goran-mahovlic/LVDS_RGB_experimental/README.md

# LVDS_RGB_experimental

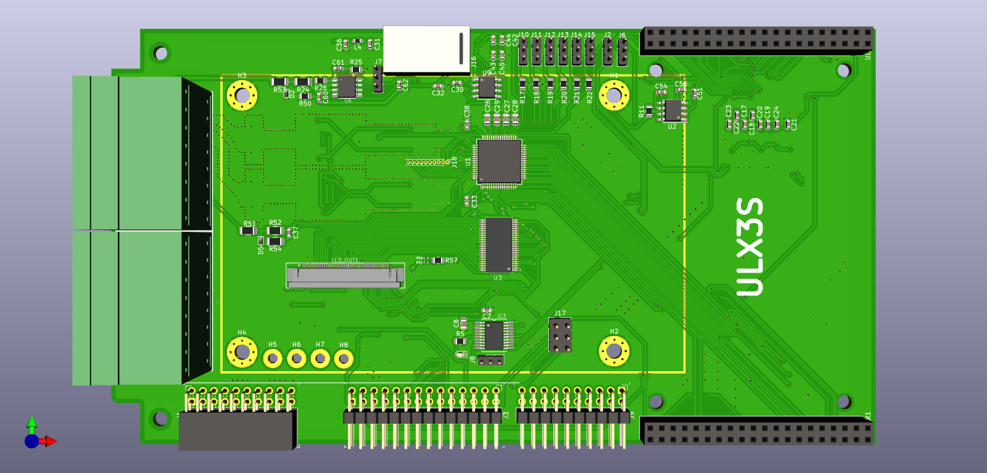
[picture p1: hardware/pic/Front.png]
Front


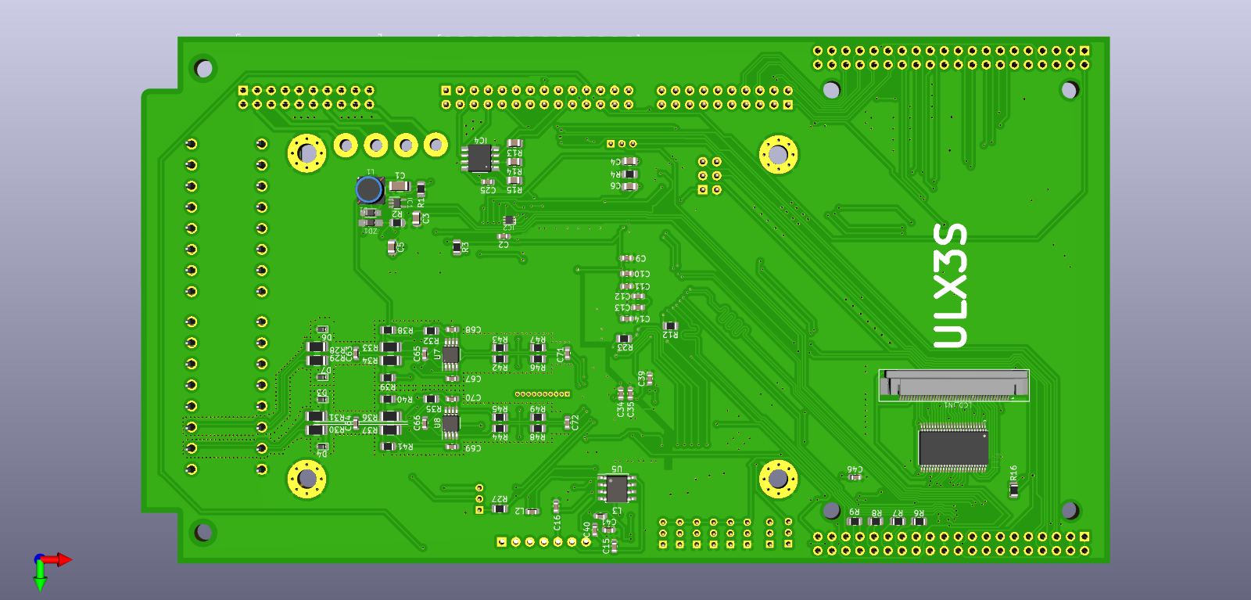
[picture p2: hardware/pic/Back.png]
Back
