goran-mahovlic/LVDS_RGB_experimental/hardware/pic/Back.jpg

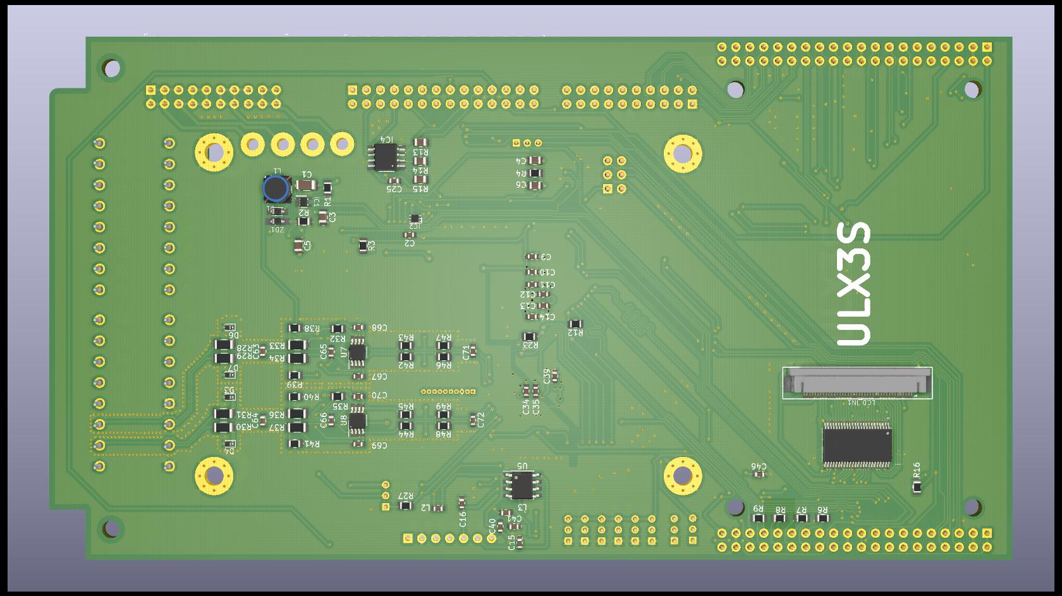
hardware/pic/Back.jpg
