goran-mahovlic/LVDS_RGB_experimental/hardware/pic/Front.jpg

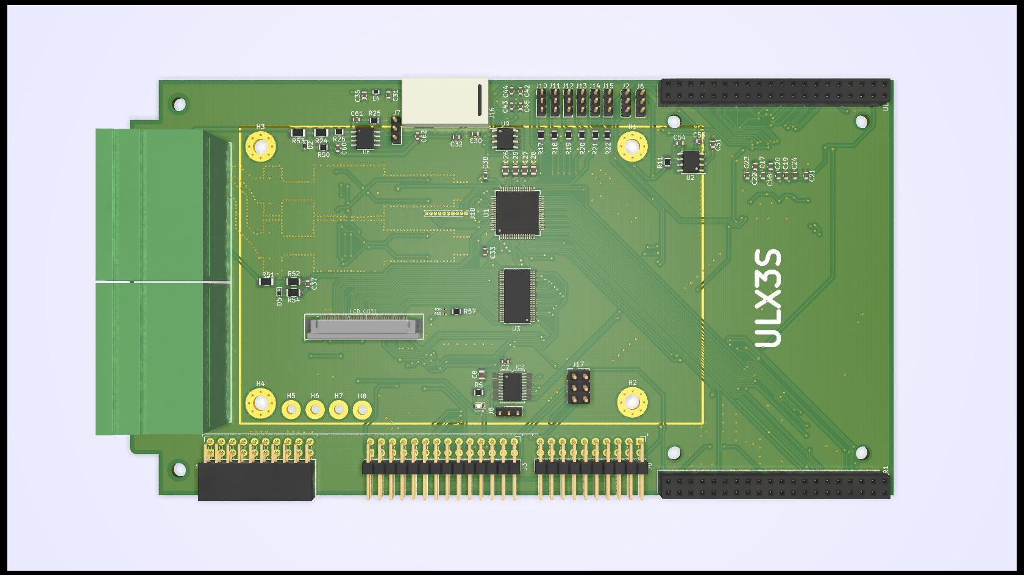
hardware/pic/Front.jpg
