goran-mahovlic/LVDS_RGB_experimental/hardware/ULX3S_Combined.FCStd

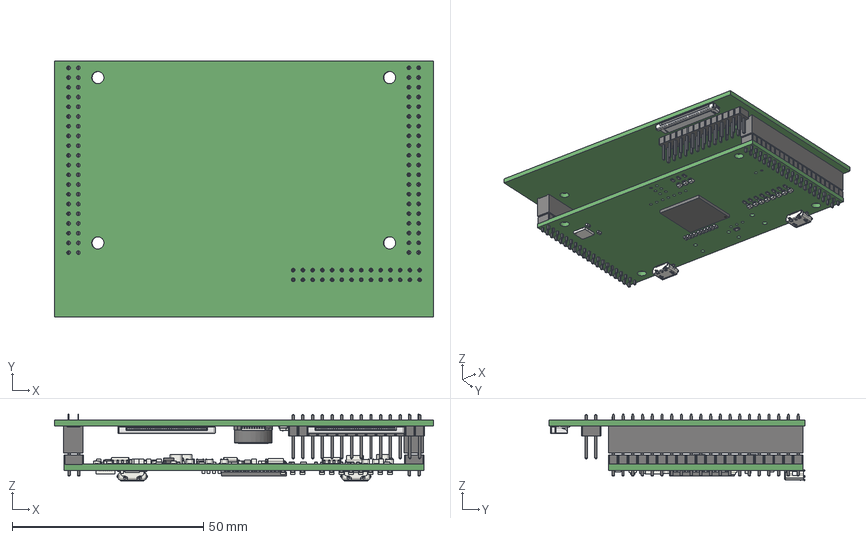
[picture p5: CAD file, 2020-01-20]
hardware/ULX3S_Combined.FCStd
99.0 x 67.0 x 17.4 mm
