goran-mahovlic/LVDS_RGB_experimental/hardware/3D/c-4-1734592-0-c-3d.stp

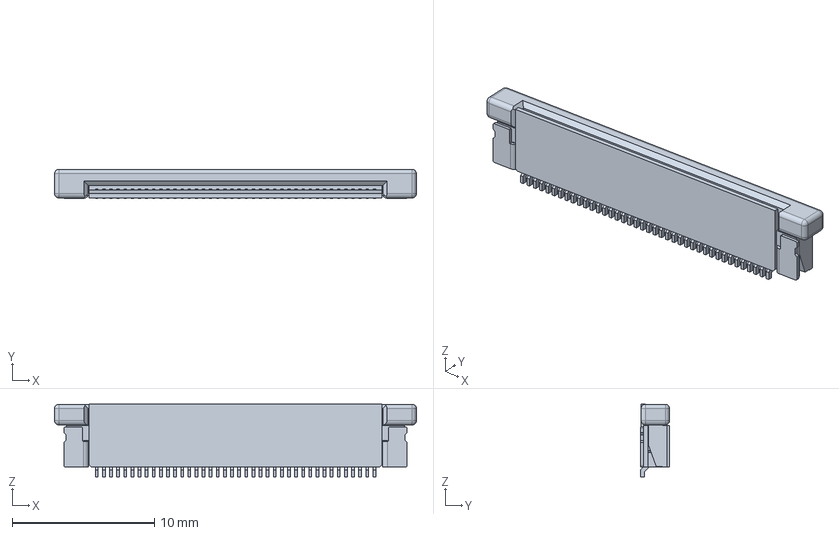
[picture p6: CAD file, 2020-01-20]
hardware/3D/c-4-1734592-0-c-3d.stp
25.4 x 2.05 x 5.11 mm
