goran-mahovlic/LVDS_RGB_experimental/hardware/3D/691327310016_Download_STP_691327310016_rev1.stp

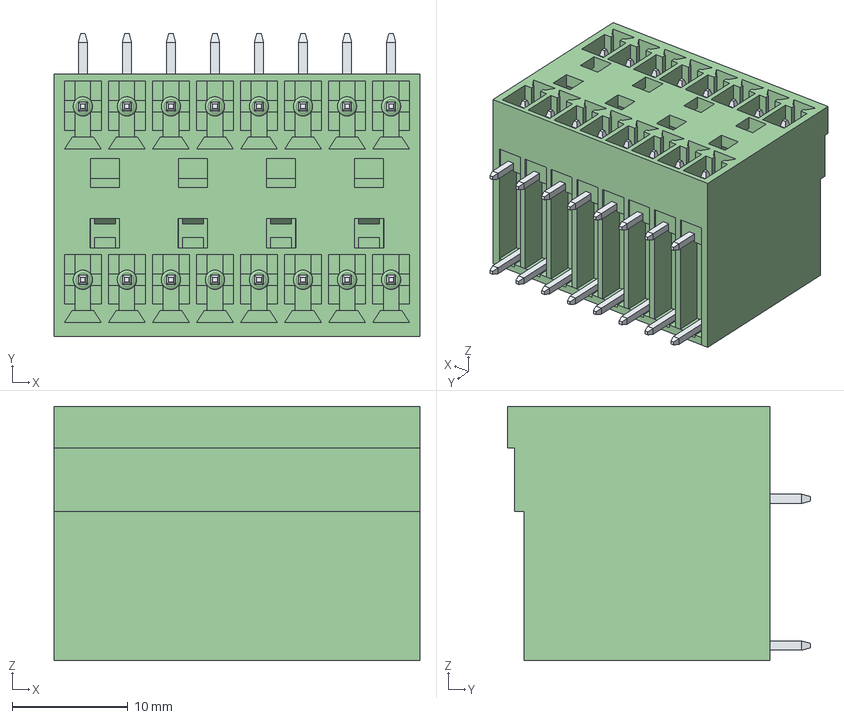
[picture p7: CAD file, 2020-01-20]
hardware/3D/691327310016_Download_STP_691327310016_rev1.stp
31.7 x 26.2 x 22.0 mm
6913273100xx_PIN x 8
6913273100xx_PIN_LONGUE x 8
691329300016_CAPOT
