goran-mahovlic/LVDS_RGB_experimental/hardware/3D/691327310012_Download_STP_691327310012_rev1.stp

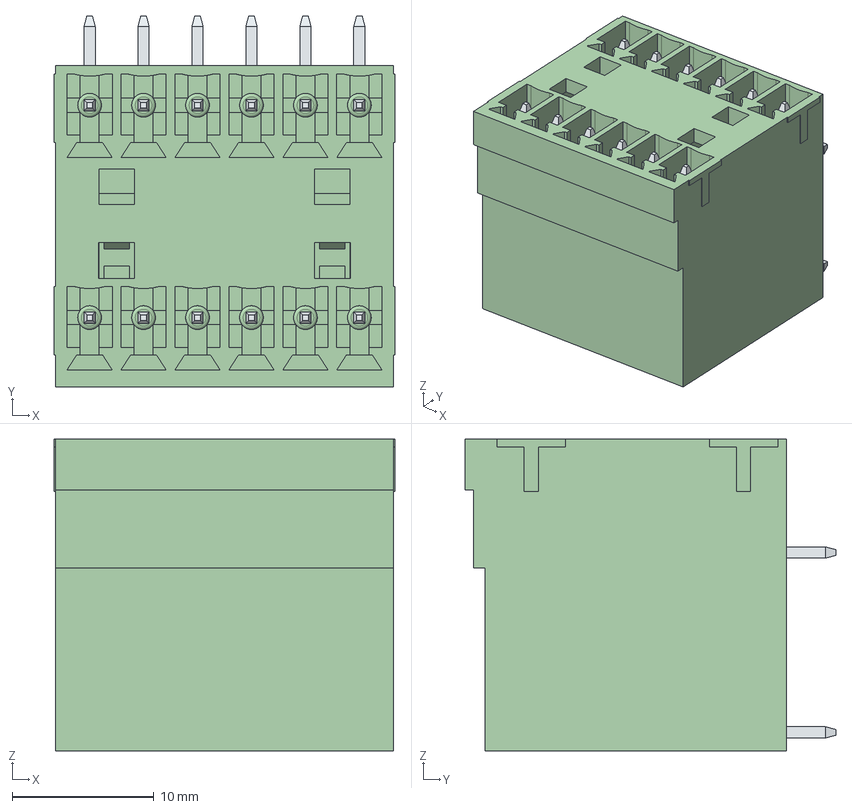
[picture p8: CAD file, 2020-01-20]
hardware/3D/691327310012_Download_STP_691327310012_rev1.stp
24.1 x 26.2 x 22.0 mm
6913273100xx_PIN x 6
6913273100xx_PIN_LONGUE x 6
691327310012_CAPOT
