goran-mahovlic/LVDS_RGB_experimental/hardware/3D/LMR14050SDDAR--3DModel-STEP-56544.STEP

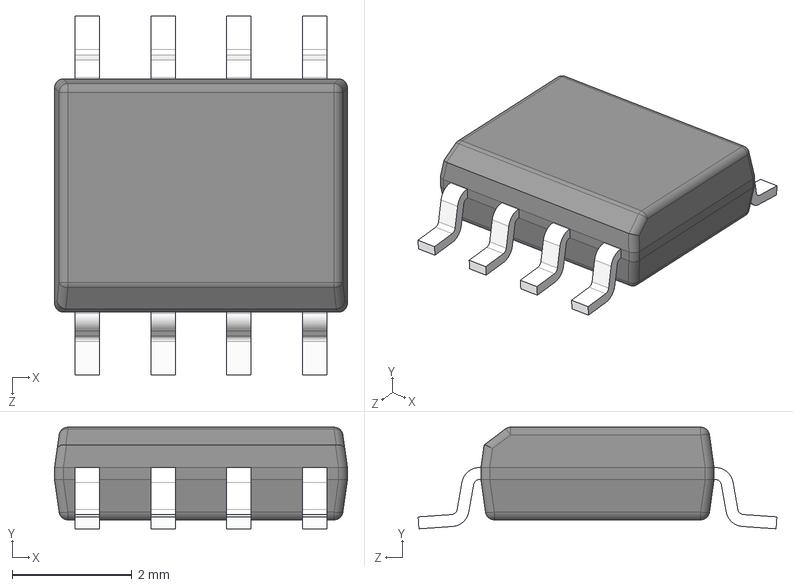
[picture p9: CAD file, 2020-01-20]
hardware/3D/LMR14050SDDAR--3DModel-STEP-56544.STEP
4.90 x 1.70 x 6.00 mm
