goran-mahovlic/LVDS_RGB_experimental/(threads)

Thread 1 (2020-02-24):

Replace all resistors and capacitors with same size

goran-mahovlic, 2020-02-24:
Go large ...

Thread 3 (2020-02-29):

LCD connector on back is flipped

goran-mahovlic, 2020-02-29:
If we use cable we need to flip connector

pin 1 is actually pin 40

QuickFix - rotate connector ...

Thread 4 (2020-03-02):

Power_Down needs to be directly connected to 3.3V

goran-mahovlic, 2020-03-02:
Connection toward STM32 LCD reset signal needs to be removed ...

Thread 5 (2020-04-18):

All selections jumper should be connected to DVDD not AVDD

goran-mahovlic, 2020-04-18:
Pins on ADC are 5V tolerant, but in datasheet it is stated to use DVDD (in our case that is 3.3V)
