goran-mahovlic/LVDS_RGB_experimental/hardware/LCD_PMOD.kicad_pcb

## KiCad design hardware/LCD_PMOD.kicad_pcb (2020-02-15)

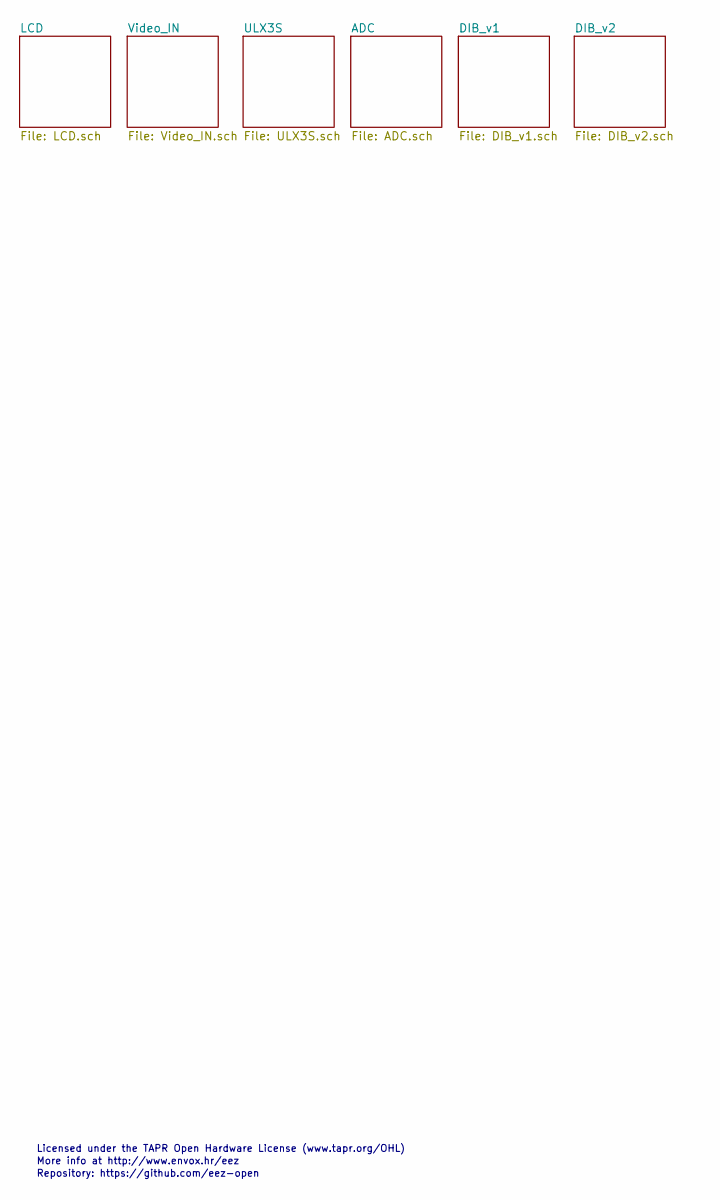
[picture p20: schematic LCD_PMOD.sch, ADC_LVDS_RGB_DIB1_DIB2]

Notes on the sheet:
Licensed under the TAPR Open Hardware License (www.tapr.org/OHL)
Repository: https://github.com/eez-open
More info at http://www.envox.hr/eez

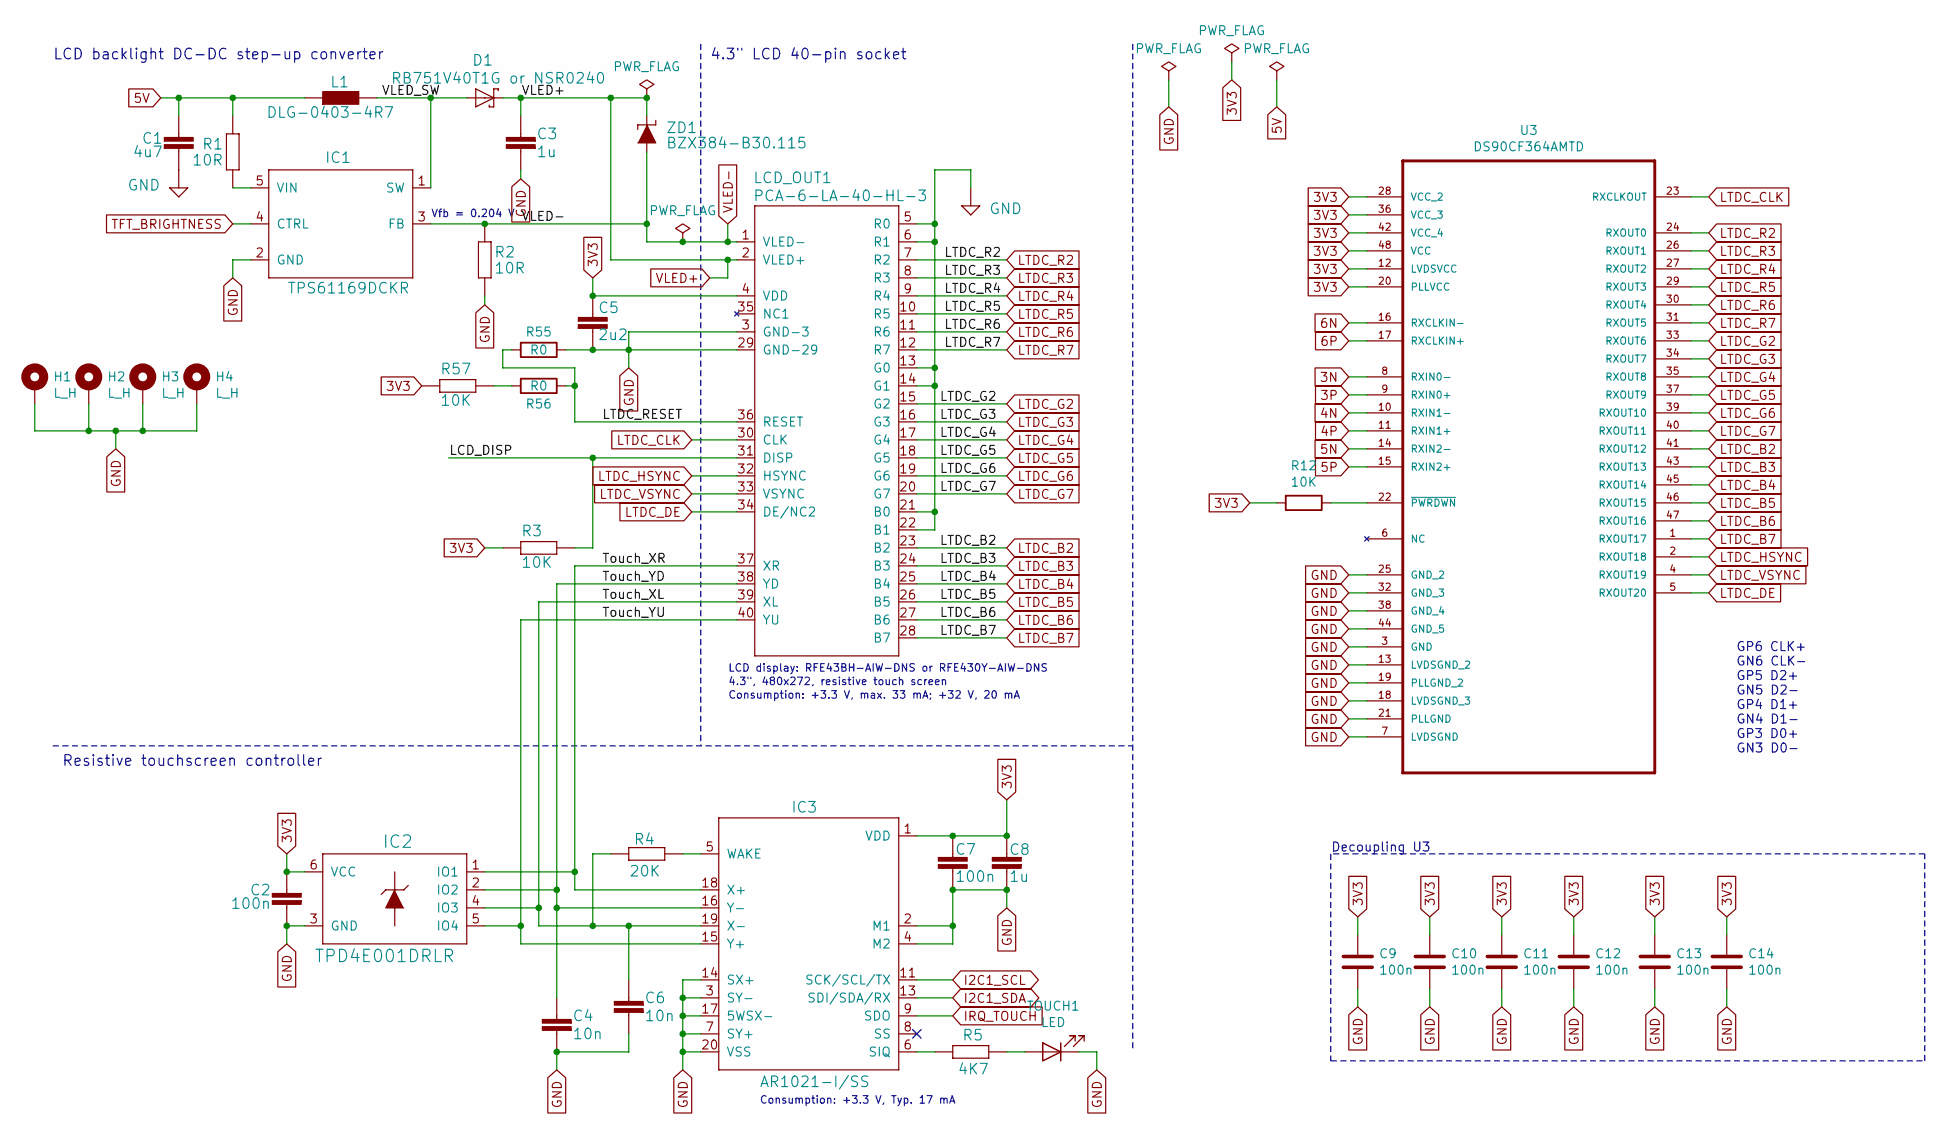
[picture p21: schematic LCD.sch]

Parts:
C1: 4u7; C_1206_3216Metric
C2, C7, C9, C10, C11, C12, C13, C14: 100n; C_0603_1608Metric
C3, C8: 1u; C_0805_2012Metric
C4, C6: 10n; C_0805_2012Metric
C5: 2u2; C_0805_2012Metric
D1: RB751V40T1G or NSR0240; SOD323-R
H1, H2, H3, H4: L_H; MountingHole_3.5mm_Pad_Via
IC1: TPS61169DCKR; DCK5
IC2: TPD4E001DRLR; DRL6
IC3: AR1021-I/SS; SOP65P780X200-20N
L1: DLG-0403-4R7; DE0403
LCD_OUT1: PCA-6-LA-40-HL-3; FPC_40
R1, R2: 10R; R_0805_2012Metric
R3, R12, R57: 10K; R_0805_2012Metric
R4: 20K; R_0805_2012Metric
R5: 4K7; R_0805_2012Metric
R55, R56: R0; R_0201_0603Metric
TOUCH1: LED; LED_0603_1608Metric
U3: DS90CF364AMTD; SOP50P800X110-48N
ZD1: BZX384-B30.115; SOD323-W

Connections:
3N: U3.8 (RXIN0-); also elsewhere on the board
3P: U3.9 (RXIN0+); also elsewhere on the board
3V3: C2.2, C5.1, C7.2, C8.2, C9.1, C10.1, C11.1, C12.1, C13.1, C14.1, IC2.6 (VCC), IC3.1 (VDD), LCD_OUT1.4 (VDD), R3.2, R12.2, R57.2, U3.12 (LVDSVCC), U3.20 (PLLVCC), U3.28 (VCC_2), U3.36 (VCC_3), U3.42 (VCC_4), U3.48 (VCC); also elsewhere on the board
4N: U3.10 (RXIN1-); also elsewhere on the board
4P: U3.11 (RXIN1+); also elsewhere on the board
5N: U3.14 (RXIN2-); also elsewhere on the board
5P: U3.15 (RXIN2+); also elsewhere on the board
5V: C1.1, L1.1, R1.1; also elsewhere on the board
6N: U3.16 (RXCLKIN-); also elsewhere on the board
6P: U3.17 (RXCLKIN+); also elsewhere on the board
8N: IC1.4 (CTRL); also elsewhere on the board
/LCD/LCD_DISP: LCD_OUT1.31 (DISP), R3.1
/LCD/LTDC_RESET: LCD_OUT1.36 (RESET), R55.2, R56.1
/LCD/Touch_XL: C6.1, IC2.4 (IO3), IC3.19 (X-), LCD_OUT1.39 (XL), R4.2
/LCD/Touch_XR: IC2.1 (IO1), IC3.18 (X+), LCD_OUT1.37 (XR)
/LCD/Touch_YD: C4.1, IC2.2 (IO2), IC3.16 (Y-), LCD_OUT1.38 (YD)
/LCD/Touch_YU: IC2.5 (IO4), IC3.15 (Y+), LCD_OUT1.40 (YU)
/LCD/VLED_SW: D1.A, IC1.1 (SW), L1.2
GND: C1.2, C2.1, C3.2, C4.2, C5.2, C6.2, C7.1, C8.1, C9.2, C10.2, C11.2, C12.2, C13.2, C14.2, H1.1, H2.1, H3.1, H4.1, IC1.2 (GND), IC2.3 (GND), IC3.2 (M1), IC3.3 (SY-), IC3.4 (M2), IC3.7 (SY+), IC3.14 (SX+), IC3.17 (5WSX-), IC3.20 (VSS), LCD_OUT1.3 (GND-3), LCD_OUT1.5 (R0), LCD_OUT1.6 (R1), LCD_OUT1.13 (G0), LCD_OUT1.14 (G1), LCD_OUT1.21 (B0), LCD_OUT1.22 (B1), LCD_OUT1.29 (GND-29), R2.2, R55.1, TOUCH1.1 (K), U3.3 (GND), U3.7 (LVDSGND), U3.13 (LVDSGND_2), U3.18 (LVDSGND_3), U3.19 (PLLGND_2), U3.21 (PLLGND), U3.25 (GND_2), U3.32 (GND_3), U3.38 (GND_4), U3.44 (GND_5); also elsewhere on the board
I2C1_SCL: IC3.11 (SCK/SCL/TX); also elsewhere on the board
I2C1_SDA: IC3.13 (SDI/SDA/RX); also elsewhere on the board
IRQ_TOUCH: IC3.9 (SDO); also elsewhere on the board
LTDC_B2: LCD_OUT1.23 (B2), U3.41 (RXOUT12)
LTDC_B3: LCD_OUT1.24 (B3), U3.43 (RXOUT13)
LTDC_B4: LCD_OUT1.25 (B4), U3.45 (RXOUT14)
LTDC_B5: LCD_OUT1.26 (B5), U3.46 (RXOUT15)
LTDC_B6: LCD_OUT1.27 (B6), U3.47 (RXOUT16)
LTDC_B7: LCD_OUT1.28 (B7), U3.1 (RXOUT17)
LTDC_CLK: LCD_OUT1.30 (CLK), U3.23 (RXCLKOUT)
LTDC_DE: LCD_OUT1.34 (DE/NC2), U3.5 (RXOUT20)
LTDC_G2: LCD_OUT1.15 (G2), U3.33 (RXOUT6)
LTDC_G3: LCD_OUT1.16 (G3), U3.34 (RXOUT7)
LTDC_G4: LCD_OUT1.17 (G4), U3.35 (RXOUT8)
LTDC_G5: LCD_OUT1.18 (G5), U3.37 (RXOUT9)
LTDC_G6: LCD_OUT1.19 (G6), U3.39 (RXOUT10)
LTDC_G7: LCD_OUT1.20 (G7), U3.40 (RXOUT11)
LTDC_HSYNC: LCD_OUT1.32 (HSYNC), U3.2 (RXOUT18)
LTDC_R2: LCD_OUT1.7 (R2), U3.24 (RXOUT0)
LTDC_R3: LCD_OUT1.8 (R3), U3.26 (RXOUT1)
LTDC_R4: LCD_OUT1.9 (R4), U3.27 (RXOUT2)
LTDC_R5: LCD_OUT1.10 (R5), U3.29 (RXOUT3)
LTDC_R6: LCD_OUT1.11 (R6), U3.30 (RXOUT4)
LTDC_R7: LCD_OUT1.12 (R7), U3.31 (RXOUT5)
LTDC_VSYNC: LCD_OUT1.33 (VSYNC), U3.4 (RXOUT19)
unnamed: IC1.5 (VIN), R1.2
unnamed: IC3.5 (WAKE), R4.1
unnamed: IC3.6 (SIQ), R5.2
unnamed: R5.1, TOUCH1.2 (A)
unnamed: R12.1, U3.22 (~PWRDWN)
unnamed: R56.2, R57.1
VLED+: C3.1, D1.C, LCD_OUT1.2 (VLED+), ZD1.C; also elsewhere on the board
VLED-: IC1.3 (FB), LCD_OUT1.1 (VLED-), R2.1, ZD1.A; also elsewhere on the board

Notes on the sheet:
4.3" LCD 40-pin socket
LCD backlight DC-DC step-up converter
Consumption: +3.3 V, Typ. 17 mA
Consumption: +3.3 V, max. 33 mA; +32 V, 20 mA
Vfb = 0.204 V
LCD display: RFE43BH-AIW-DNS or RFE430Y-AIW-DNS
4.3", 480x272, resistive touch screen
Resistive touchscreen controller
GP6 CLK+ GN6 CLK- GP5 D2+ GN5 D2- GP4 D1+ GN4 D1- GP3 D0+ GN3 D0-
Decoupling U3

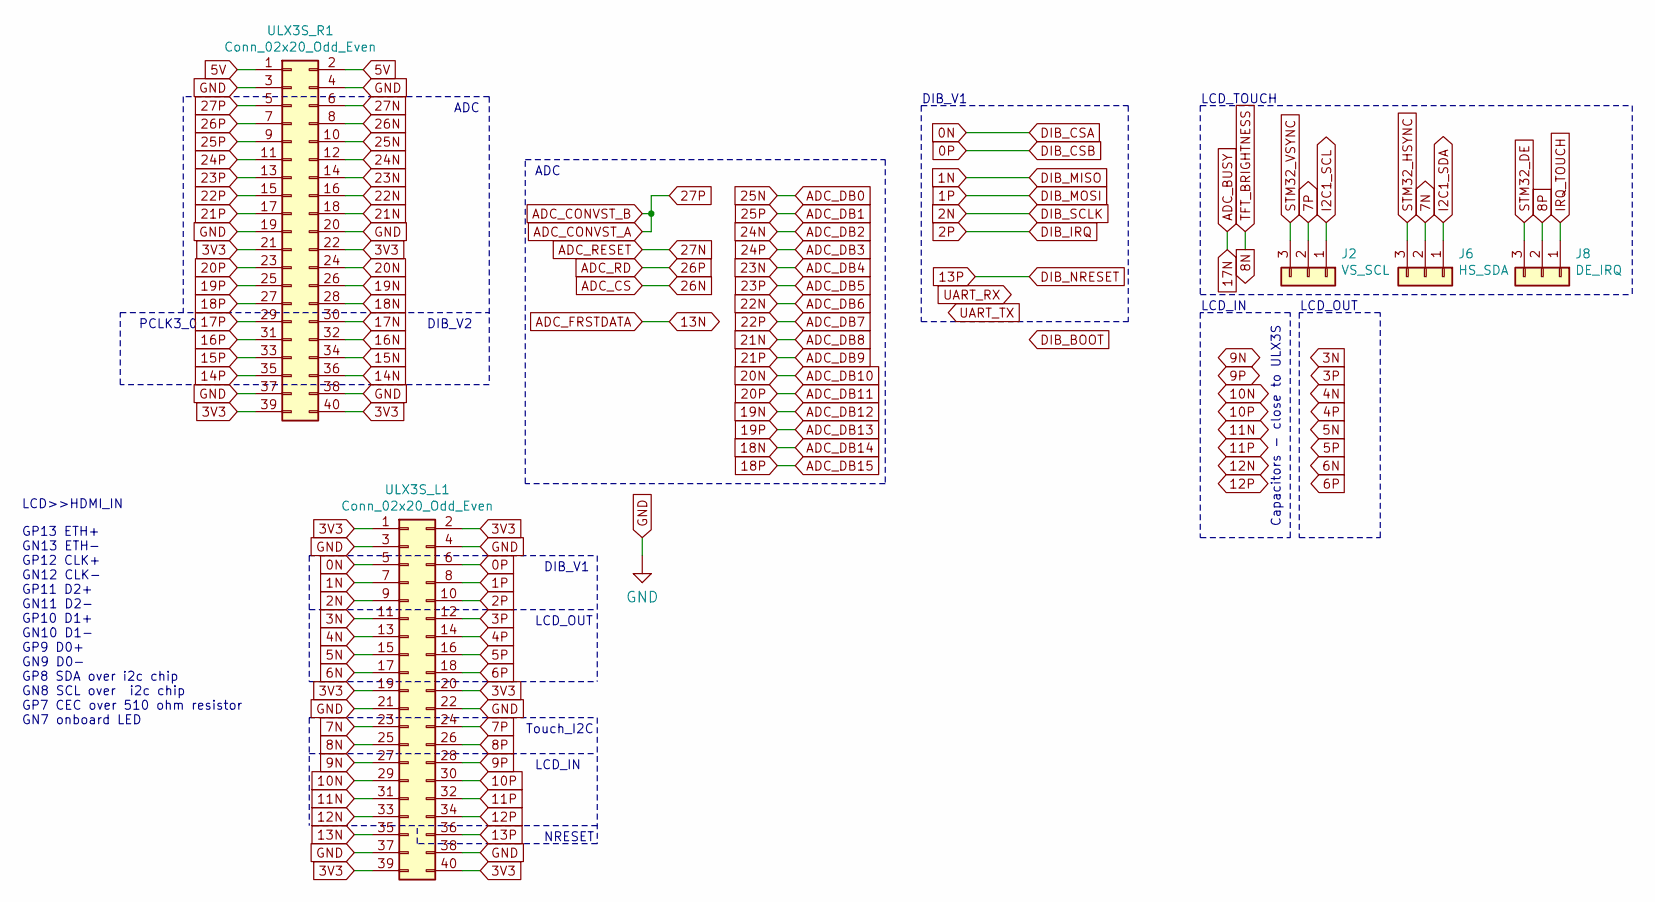
[picture p22: schematic ULX3S.sch]

Parts:
J2: VS_SCL; PinHeader_1x03_P2.00mm_Vertical
J6: HS_SDA; PinHeader_1x03_P2.00mm_Vertical
J8: DE_IRQ; PinHeader_1x03_P2.00mm_Vertical
ULX3S_L1, ULX3S_R1: Conn_02x20_Odd_Even; PinSocket_2x20_P2.54mm_Vertical

Connections:
0N: ULX3S_L1.5; also elsewhere on the board
0P: ULX3S_L1.6; also elsewhere on the board
1N: ULX3S_L1.7; also elsewhere on the board
1P: ULX3S_L1.8; also elsewhere on the board
2N: ULX3S_L1.9; also elsewhere on the board
2P: ULX3S_L1.10; also elsewhere on the board
3N: ULX3S_L1.11; also elsewhere on the board
3P: ULX3S_L1.12; also elsewhere on the board
3V3: ULX3S_L1.1, ULX3S_L1.2, ULX3S_L1.19, ULX3S_L1.20, ULX3S_L1.39, ULX3S_L1.40, ULX3S_R1.21, ULX3S_R1.22, ULX3S_R1.39, ULX3S_R1.40; also elsewhere on the board
4N: ULX3S_L1.13; also elsewhere on the board
4P: ULX3S_L1.14; also elsewhere on the board
5N: ULX3S_L1.15; also elsewhere on the board
5P: ULX3S_L1.16; also elsewhere on the board
5V: ULX3S_R1.1, ULX3S_R1.2; also elsewhere on the board
6N: ULX3S_L1.17; also elsewhere on the board
6P: ULX3S_L1.18; also elsewhere on the board
7N: J6.2, ULX3S_L1.23
7P: J2.2, ULX3S_L1.24
8N: ULX3S_L1.25; also elsewhere on the board
8P: J8.2, ULX3S_L1.26
9N: ULX3S_L1.27; also elsewhere on the board
9P: ULX3S_L1.28; also elsewhere on the board
10N: ULX3S_L1.29; also elsewhere on the board
10P: ULX3S_L1.30; also elsewhere on the board
11N: ULX3S_L1.31; also elsewhere on the board
11P: ULX3S_L1.32; also elsewhere on the board
12N: ULX3S_L1.33; also elsewhere on the board
12P: ULX3S_L1.34; also elsewhere on the board
13N: ULX3S_L1.35; also elsewhere on the board
13P: ULX3S_L1.36; also elsewhere on the board
14N: ULX3S_R1.36; also elsewhere on the board
14P: ULX3S_R1.35; also elsewhere on the board
15N: ULX3S_R1.34; also elsewhere on the board
15P: ULX3S_R1.33; also elsewhere on the board
16N: ULX3S_R1.32; also elsewhere on the board
16P: ULX3S_R1.31; also elsewhere on the board
17N: ULX3S_R1.30; also elsewhere on the board
17P: ULX3S_R1.29; also elsewhere on the board
18N: ULX3S_R1.28; also elsewhere on the board
18P: ULX3S_R1.27; also elsewhere on the board
19N: ULX3S_R1.26; also elsewhere on the board
19P: ULX3S_R1.25; also elsewhere on the board
20N: ULX3S_R1.24; also elsewhere on the board
20P: ULX3S_R1.23; also elsewhere on the board
21N: ULX3S_R1.18; also elsewhere on the board
21P: ULX3S_R1.17; also elsewhere on the board
22N: ULX3S_R1.16; also elsewhere on the board
22P: ULX3S_R1.15; also elsewhere on the board
23N: ULX3S_R1.14; also elsewhere on the board
23P: ULX3S_R1.13; also elsewhere on the board
24N: ULX3S_R1.12; also elsewhere on the board
24P: ULX3S_R1.11; also elsewhere on the board
25N: ULX3S_R1.10; also elsewhere on the board
25P: ULX3S_R1.9; also elsewhere on the board
26N: ULX3S_R1.8; also elsewhere on the board
26P: ULX3S_R1.7; also elsewhere on the board
27N: ULX3S_R1.6; also elsewhere on the board
27P: ULX3S_R1.5; also elsewhere on the board
GND: ULX3S_L1.3, ULX3S_L1.4, ULX3S_L1.21, ULX3S_L1.22, ULX3S_L1.37, ULX3S_L1.38, ULX3S_R1.3, ULX3S_R1.4, ULX3S_R1.19, ULX3S_R1.20, ULX3S_R1.37, ULX3S_R1.38; also elsewhere on the board
I2C1_SCL: J2.1; also elsewhere on the board
I2C1_SDA: J6.1; also elsewhere on the board
IRQ_TOUCH: J8.1; also elsewhere on the board
STM32_DE: J8.3; also elsewhere on the board
STM32_HSYNC: J6.3; also elsewhere on the board
STM32_VSYNC: J2.3; also elsewhere on the board

Notes on the sheet:
GP13 ETH+ GN13 ETH- GP12 CLK+ GN12 CLK- GP11 D2+ GN11 D2- GP10 D1+ GN10 D1- GP9 D0+ GN9 D0- GP8 SDA over i2c chip GN8 SCL over i2c chip GP7 CEC over 510 ohm resistor GN7 onboard LED
LCD>>HDMI_IN
DIB_V1
LCD_TOUCH
Capacitors - close to ULX3S
LCD_IN
LCD_OUT
Touch_I2C
ADC
NRESET
PCLK3_0
DIB_V2

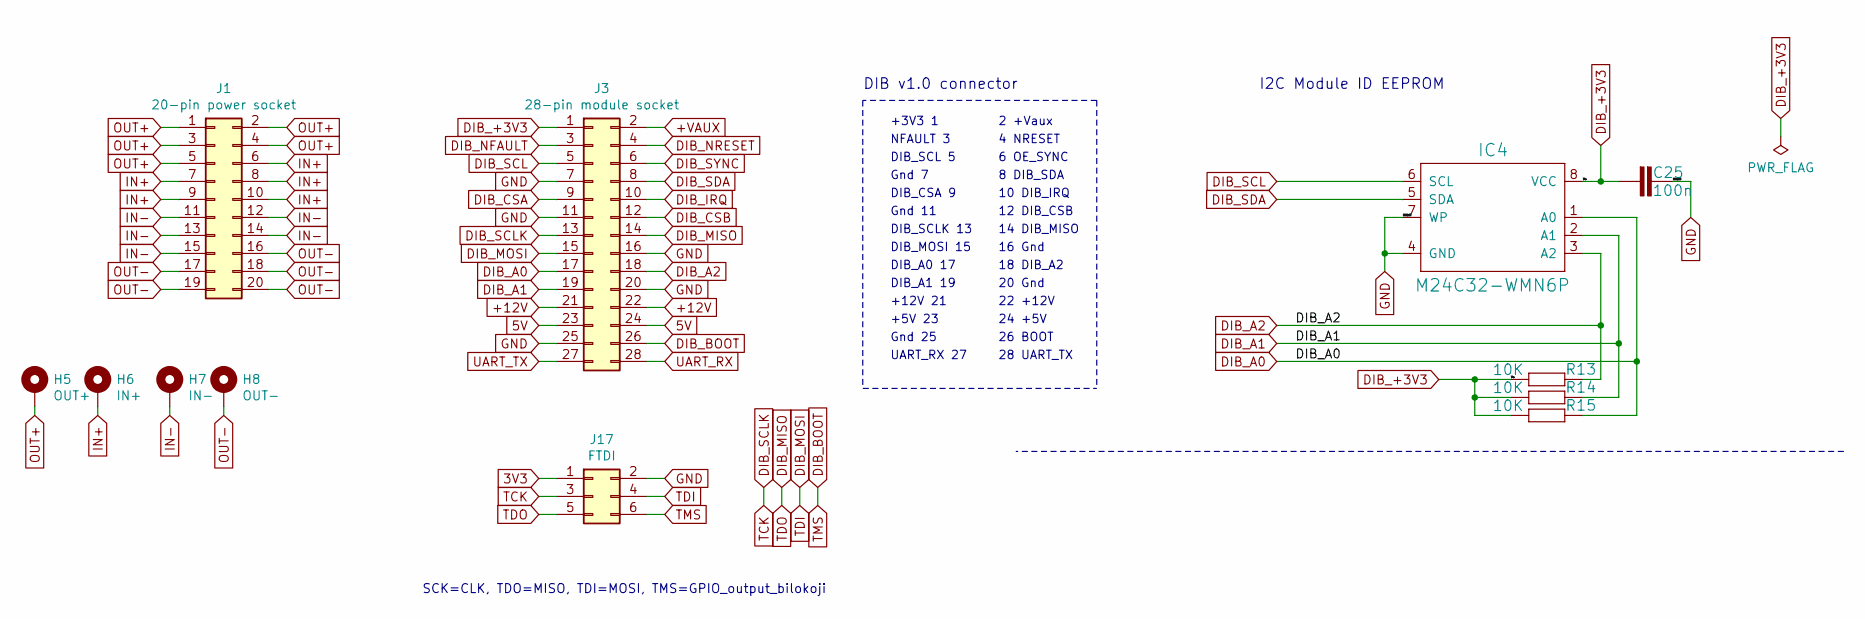
[picture p23: schematic DIB_v1.sch]

Parts:
C25: 100n; C_0603_1608Metric
H5: OUT+; MountingHole_2.2mm_M2_Pad
H6: IN+; MountingHole_2.2mm_M2_Pad
H7: IN-; MountingHole_2.2mm_M2_Pad
H8: OUT-; MountingHole_2.2mm_M2_Pad
IC4: M24C32-WMN6P; SOIC127P600X170-9N
J1: 20-pin power socket; PinSocket_2x10_P2.54mm_Horizontal_DIB_V1
J3: 28-pin module socket; PinHeader_2x14_P2.54mm_Horizontal_DIB_V1
J17: FTDI; PinHeader_2x03_P2.54mm_Vertical
R13, R14, R15: 10K; C_0805_2012Metric

Connections:
0N: J3.9; also elsewhere on the board
0P: J3.12; also elsewhere on the board
1N: J3.14, J17.5; also elsewhere on the board
1P: J3.15, J17.4; also elsewhere on the board
2N: J3.13, J17.3; also elsewhere on the board
2P: J3.10; also elsewhere on the board
3V3: J17.1; also elsewhere on the board
5V: J3.23, J3.24; also elsewhere on the board
13P: J3.4; also elsewhere on the board
+12V: J3.21, J3.22; also elsewhere on the board
DIB_+3V3: C25.2, IC4.8 (VCC), J3.1, R13.1, R14.1, R15.1
DIB_A0: IC4.1 (A0), J3.17, R15.2
DIB_A1: IC4.2 (A1), J3.19, R14.2
DIB_A2: IC4.3 (A2), J3.18, R13.2
DIB_BOOT: J3.26, J17.6
DIB_SCL: IC4.6 (SCL), J3.5
DIB_SDA: IC4.5 (SDA), J3.8
GND: C25.1, IC4.4 (GND), IC4.7 (WP), J3.7, J3.11, J3.16, J3.20, J3.25, J17.2; also elsewhere on the board
IN+: H6.1, J1.6, J1.7, J1.8, J1.9, J1.10
IN-: H7.1, J1.11, J1.12, J1.13, J1.14, J1.15
OUT+: H5.1, J1.1, J1.2, J1.3, J1.4, J1.5
OUT-: H8.1, J1.16, J1.17, J1.18, J1.19, J1.20

Notes on the sheet:
26 BOOT
Gnd 7
22 +12V
16 Gnd
6 OE_SYNC
24 +5V
+5V 23
Gnd 25
+12V 21
10 DIB_IRQ
DIB_CSA 9
2 +Vaux
12 DIB_CSB
+3V3 1
Gnd 11
8 DIB_SDA
DIB_SCL 5
DIB_A1 19
4 NRESET
DIB_A0 17
20 Gnd
NFAULT 3
14 DIB_MISO
DIB_MOSI 15
DIB_SCLK 13
18 DIB_A2
UART_RX 27
28 UART_TX
DIB v1.0 connector
I2C Module ID EEPROM
SCK=CLK, TDO=MISO, TDI=MOSI, TMS=GPIO_output_bilokoji

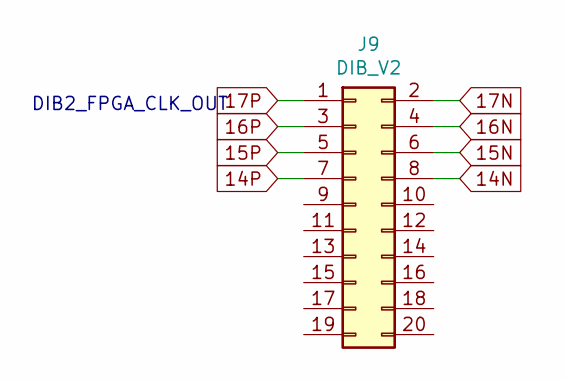
[picture p24: schematic DIB_v2.sch]

Parts:
J9: DIB_V2; PinHeader_2x10_P2.54mm_Horizontal

Connections:
14N: J9.8; also elsewhere on the board
14P: J9.7; also elsewhere on the board
15N: J9.6; also elsewhere on the board
15P: J9.5; also elsewhere on the board
16N: J9.4; also elsewhere on the board
16P: J9.3; also elsewhere on the board
17N: J9.2; also elsewhere on the board
17P: J9.1; also elsewhere on the board

Notes on the sheet:
DIB2_FPGA_CLK_OUT

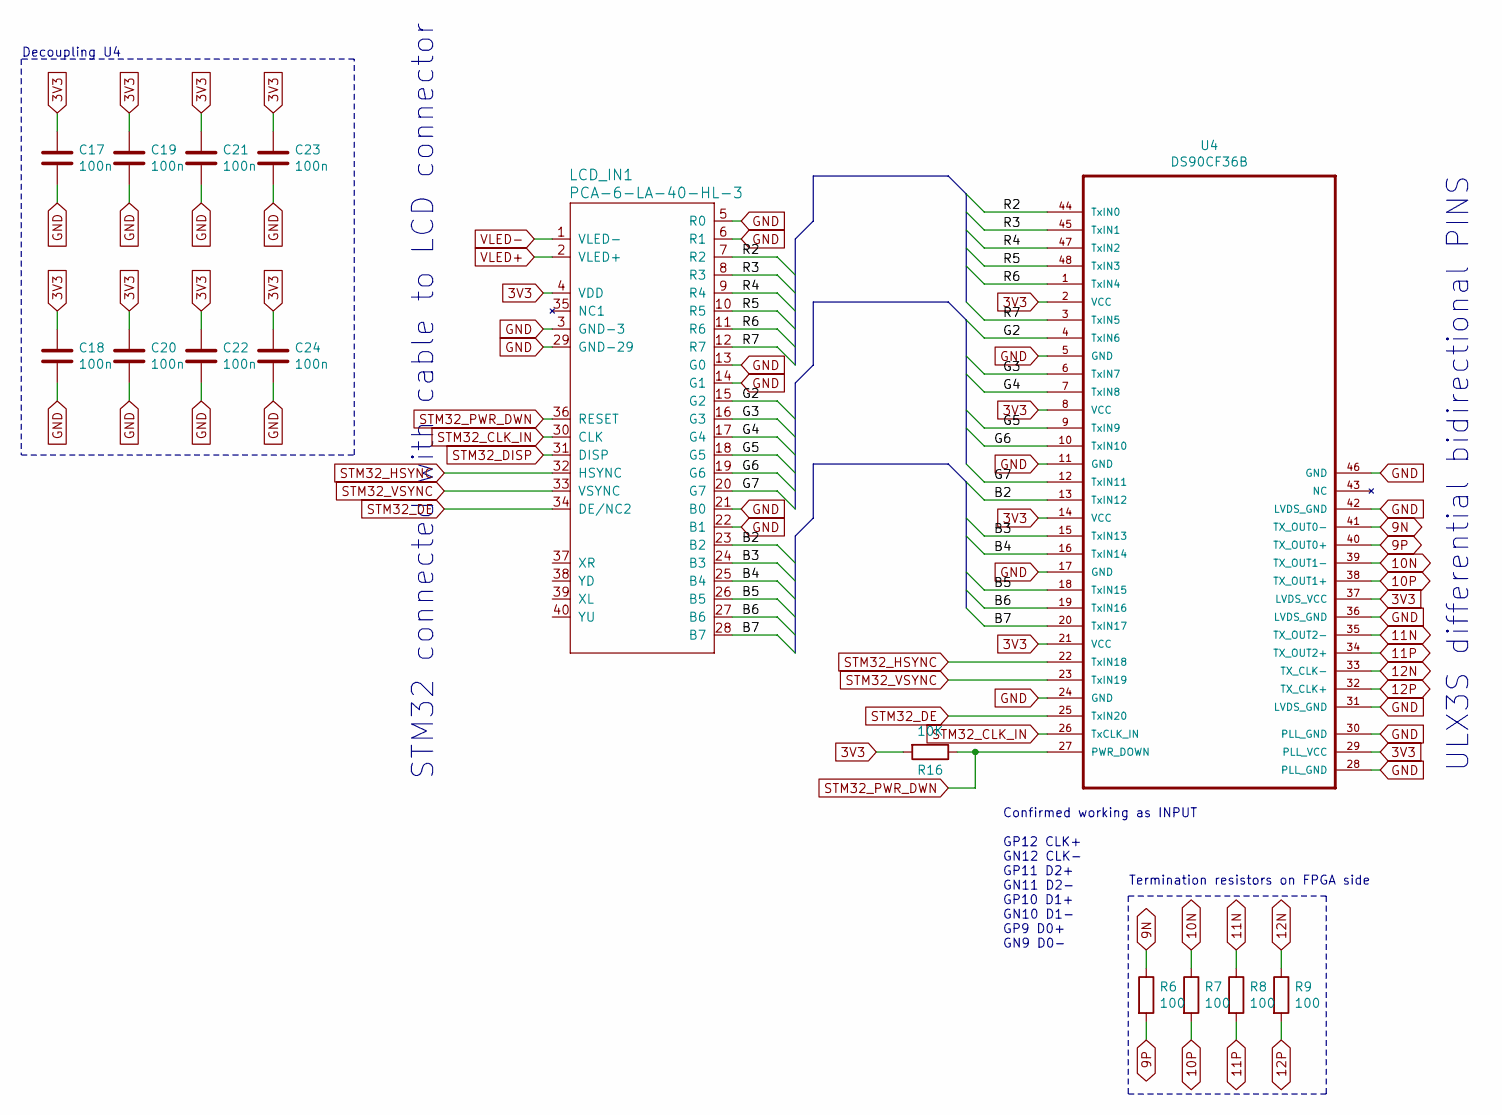
[picture p25: schematic Video_IN.sch]

Parts:
C17, C18, C19, C20, C21, C22, C23, C24: 100n; C_0603_1608Metric
LCD_IN1: PCA-6-LA-40-HL-3; FPC_40
R6, R7, R8, R9: 100; R_0805_2012Metric
R16: 10K; R_0805_2012Metric
U4: DS90CF36B; SOP50P800X110-48N

Connections:
3V3: C17.1, C18.1, C19.1, C20.1, C21.1, C22.1, C23.1, C24.1, LCD_IN1.4 (VDD), R16.2, U4.2 (VCC), U4.8 (VCC), U4.14 (VCC), U4.21 (VCC), U4.29 (PLL_VCC), U4.37 (LVDS_VCC); also elsewhere on the board
9N: R6.1, U4.41 (TX_OUT0-); also elsewhere on the board
9P: R6.2, U4.40 (TX_OUT0+); also elsewhere on the board
10N: R7.1, U4.39 (TX_OUT1-); also elsewhere on the board
10P: R7.2, U4.38 (TX_OUT1+); also elsewhere on the board
11N: R8.1, U4.35 (TX_OUT2-); also elsewhere on the board
11P: R8.2, U4.34 (TX_OUT2+); also elsewhere on the board
12N: R9.1, U4.33 (TX_CLK-); also elsewhere on the board
12P: R9.2, U4.32 (TX_CLK+); also elsewhere on the board
/Video_IN/B2: LCD_IN1.23 (B2), U4.13 (TxIN12)
/Video_IN/B3: LCD_IN1.24 (B3), U4.15 (TxIN13)
/Video_IN/B4: LCD_IN1.25 (B4), U4.16 (TxIN14)
/Video_IN/B5: LCD_IN1.26 (B5), U4.18 (TxIN15)
/Video_IN/B6: LCD_IN1.27 (B6), U4.19 (TxIN16)
/Video_IN/B7: LCD_IN1.28 (B7), U4.20 (TxIN17)
/Video_IN/G2: LCD_IN1.15 (G2), U4.4 (TxIN6)
/Video_IN/G3: LCD_IN1.16 (G3), U4.6 (TxIN7)
/Video_IN/G4: LCD_IN1.17 (G4), U4.7 (TxIN8)
/Video_IN/G5: LCD_IN1.18 (G5), U4.9 (TxIN9)
/Video_IN/G6: LCD_IN1.19 (G6), U4.10 (TxIN10)
/Video_IN/G7: LCD_IN1.20 (G7), U4.12 (TxIN11)
/Video_IN/R2: LCD_IN1.7 (R2), U4.44 (TxIN0)
/Video_IN/R3: LCD_IN1.8 (R3), U4.45 (TxIN1)
/Video_IN/R4: LCD_IN1.9 (R4), U4.47 (TxIN2)
/Video_IN/R5: LCD_IN1.10 (R5), U4.48 (TxIN3)
/Video_IN/R6: LCD_IN1.11 (R6), U4.1 (TxIN4)
/Video_IN/R7: LCD_IN1.12 (R7), U4.3 (TxIN5)
GND: C17.2, C18.2, C19.2, C20.2, C21.2, C22.2, C23.2, C24.2, LCD_IN1.3 (GND-3), LCD_IN1.5 (R0), LCD_IN1.6 (R1), LCD_IN1.13 (G0), LCD_IN1.14 (G1), LCD_IN1.21 (B0), LCD_IN1.22 (B1), LCD_IN1.29 (GND-29), U4.5 (GND), U4.11 (GND), U4.17 (GND), U4.24 (GND), U4.28 (PLL_GND), U4.30 (PLL_GND), U4.31 (LVDS_GND), U4.36 (LVDS_GND), U4.42 (LVDS_GND), U4.46 (GND); also elsewhere on the board
STM32_CLK_IN: LCD_IN1.30 (CLK), U4.26 (TxCLK_IN)
STM32_DE: LCD_IN1.34 (DE/NC2), U4.25 (TxIN20); also elsewhere on the board
STM32_HSYNC: LCD_IN1.32 (HSYNC), U4.22 (TxIN18); also elsewhere on the board
STM32_PWR_DWN: LCD_IN1.36 (RESET), R16.1, U4.27 (PWR_DOWN)
STM32_VSYNC: LCD_IN1.33 (VSYNC), U4.23 (TxIN19); also elsewhere on the board
VLED+: LCD_IN1.2 (VLED+); also elsewhere on the board
VLED-: LCD_IN1.1 (VLED-); also elsewhere on the board

Notes on the sheet:
Confirmed working as INPUT GP12 CLK+ GN12 CLK- GP11 D2+ GN11 D2- GP10 D1+ GN10 D1- GP9 D0+ GN9 D0-
STM32 connected with cable to LCD connector
ULX3S differential bidirectional PINS
Decoupling U4
Termination resistors on FPGA side

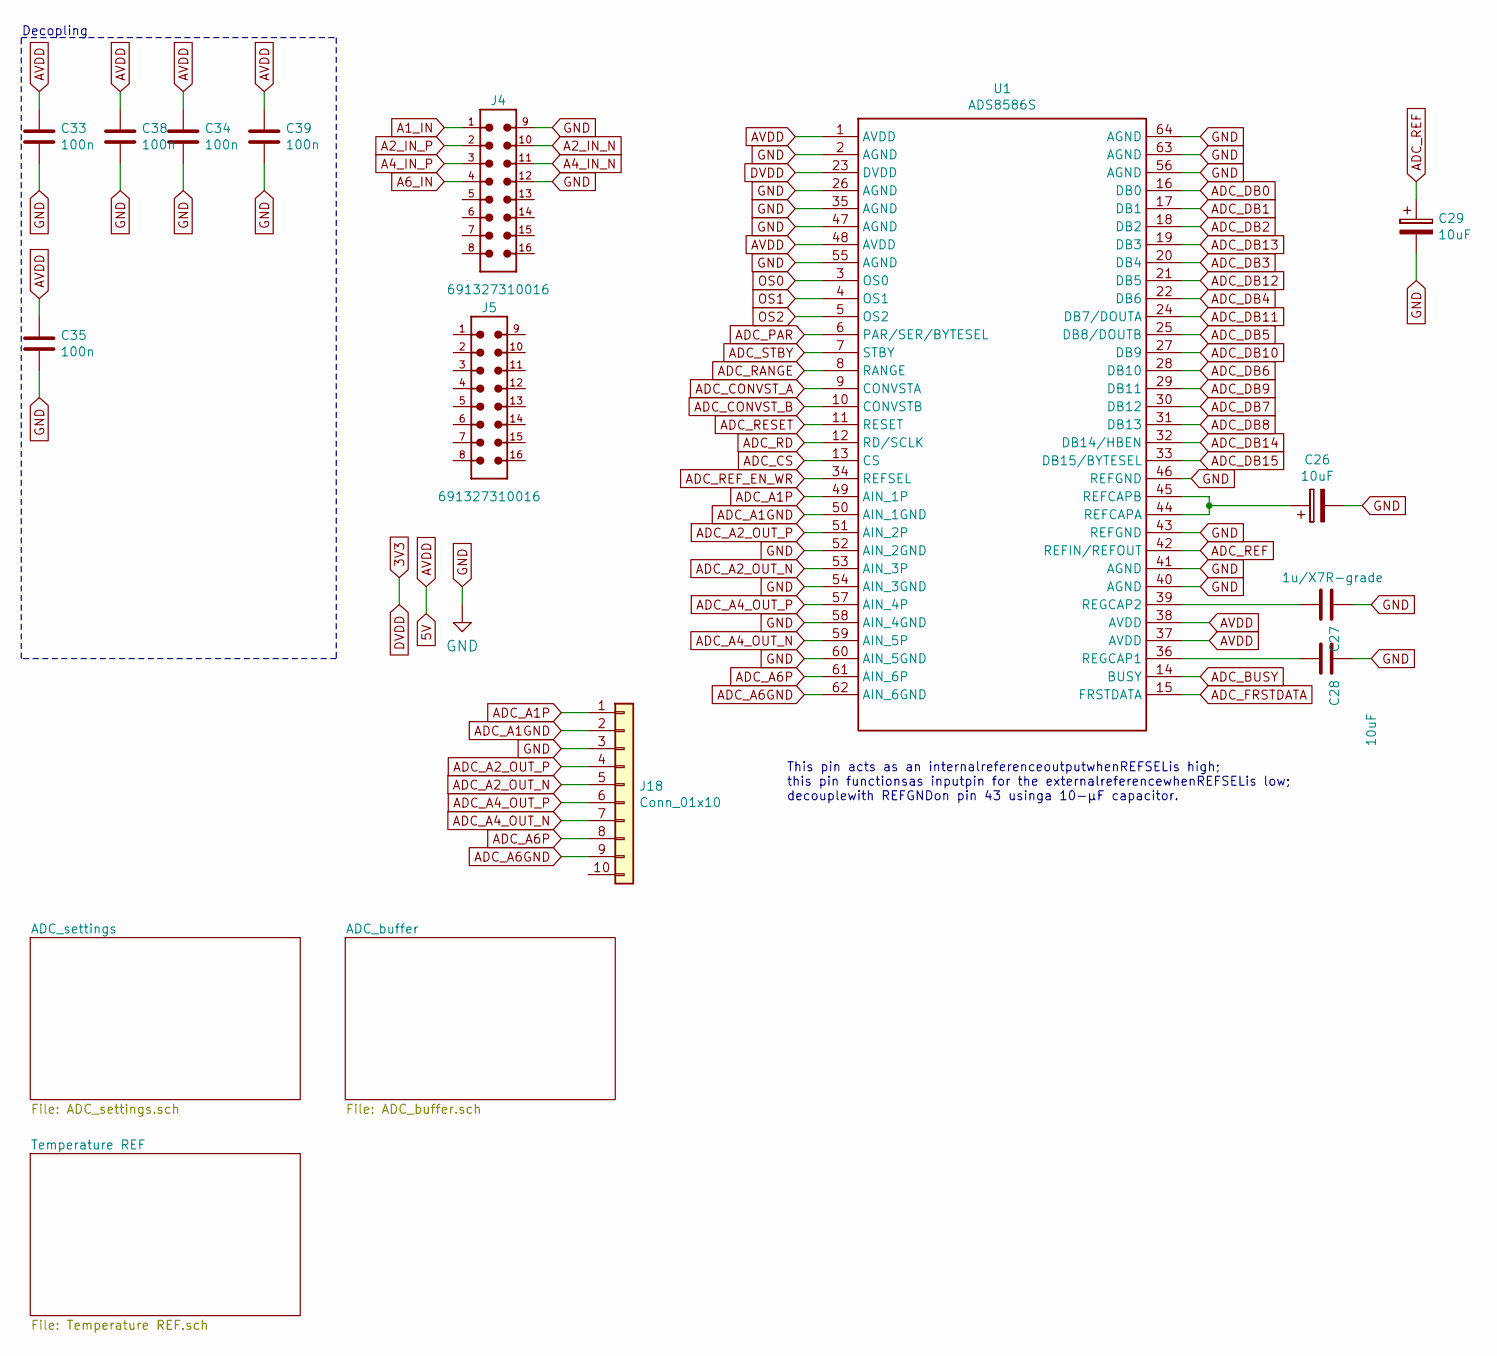
[picture p26: schematic ADC.sch]

Parts:
C26, C28, C29: 10uF; C_0805_2012Metric
C27: 1u/X7R-grade; C_0805_2012Metric
C33, C34, C35, C38, C39: 100n; C_0603_1608Metric
J4, J5: 691327310016
J18: Conn_01x10; PinHeader_1x10_P1.00mm_Vertical
U1: ADS8586S; LQFP-64_10x10mm_P0.5mm

Connections:
3V3: U1.23 (DVDD); also elsewhere on the board
5V: C33.1, C34.1, C35.1, C38.1, C39.1, U1.1 (AVDD), U1.37 (AVDD), U1.38 (AVDD), U1.48 (AVDD); also elsewhere on the board
13N: U1.15 (FRSTDATA); also elsewhere on the board
17N: U1.14 (BUSY); also elsewhere on the board
18N: U1.32 (DB14/HBEN); also elsewhere on the board
18P: U1.33 (DB15/BYTESEL); also elsewhere on the board
19N: U1.21 (DB5); also elsewhere on the board
19P: U1.19 (DB3); also elsewhere on the board
20N: U1.27 (DB9); also elsewhere on the board
20P: U1.24 (DB7/DOUTA); also elsewhere on the board
21N: U1.31 (DB13); also elsewhere on the board
21P: U1.29 (DB11); also elsewhere on the board
22N: U1.28 (DB10); also elsewhere on the board
22P: U1.30 (DB12); also elsewhere on the board
23N: U1.22 (DB6); also elsewhere on the board
23P: U1.25 (DB8/DOUTB); also elsewhere on the board
24N: U1.18 (DB2); also elsewhere on the board
24P: U1.20 (DB4); also elsewhere on the board
25N: U1.16 (DB0); also elsewhere on the board
25P: U1.17 (DB1); also elsewhere on the board
26N: U1.13 (CS); also elsewhere on the board
26P: U1.12 (RD/SCLK); also elsewhere on the board
27N: U1.11 (RESET); also elsewhere on the board
27P: U1.9 (CONVSTA), U1.10 (CONVSTB); also elsewhere on the board
A1_IN: J4.1; also elsewhere on the board
A2_IN_N: J4.10; also elsewhere on the board
A2_IN_P: J4.2; also elsewhere on the board
A4_IN_N: J4.11; also elsewhere on the board
A4_IN_P: J4.3; also elsewhere on the board
A6_IN: J4.4; also elsewhere on the board
ADC_A1GND: J18.2, U1.50 (AIN_1GND); also elsewhere on the board
ADC_A1P: J18.1, U1.49 (AIN_1P); also elsewhere on the board
ADC_A2_OUT_N: J18.5, U1.53 (AIN_3P); also elsewhere on the board
ADC_A2_OUT_P: J18.4, U1.51 (AIN_2P); also elsewhere on the board
ADC_A4_OUT_N: J18.7, U1.59 (AIN_5P); also elsewhere on the board
ADC_A4_OUT_P: J18.6, U1.57 (AIN_4P); also elsewhere on the board
ADC_A6GND: J18.9, U1.62 (AIN_6GND); also elsewhere on the board
ADC_A6P: J18.8, U1.61 (AIN_6P); also elsewhere on the board
ADC_PAR: U1.6 (PAR/SER/BYTESEL); also elsewhere on the board
ADC_RANGE: U1.8 (RANGE); also elsewhere on the board
ADC_REF: C29.1, U1.42 (REFIN/REFOUT); also elsewhere on the board
ADC_REF_EN_WR: U1.34 (REFSEL); also elsewhere on the board
ADC_STBY: U1.7 (STBY); also elsewhere on the board
GND: C26.2, C27.1, C28.1, C29.2, C33.2, C34.2, C35.2, C38.2, C39.2, J4.9, J4.12, J18.3, U1.2 (AGND), U1.26 (AGND), U1.35 (AGND), U1.40 (AGND), U1.41 (AGND), U1.43 (REFGND), U1.46 (REFGND), U1.47 (AGND), U1.52 (AIN_2GND), U1.54 (AIN_3GND), U1.55 (AGND), U1.56 (AGND), U1.58 (AIN_4GND), U1.60 (AIN_5GND), U1.63 (AGND), U1.64 (AGND); also elsewhere on the board
unnamed: C26.1, U1.44 (REFCAPA), U1.45 (REFCAPB)
unnamed: C27.2, U1.39 (REGCAP2)
unnamed: C28.2, U1.36 (REGCAP1)
OS0: U1.3 (OS0); also elsewhere on the board
OS1: U1.4 (OS1); also elsewhere on the board
OS2: U1.5 (OS2); also elsewhere on the board

Notes on the sheet:
Decopling
This pin acts as an internalreferenceoutputwhenREFSELis high; this pin functionsas inputpin for the externalreferencewhenREFSELis low; decouplewith REFGNDon pin 43 usinga 10-μF capacitor.

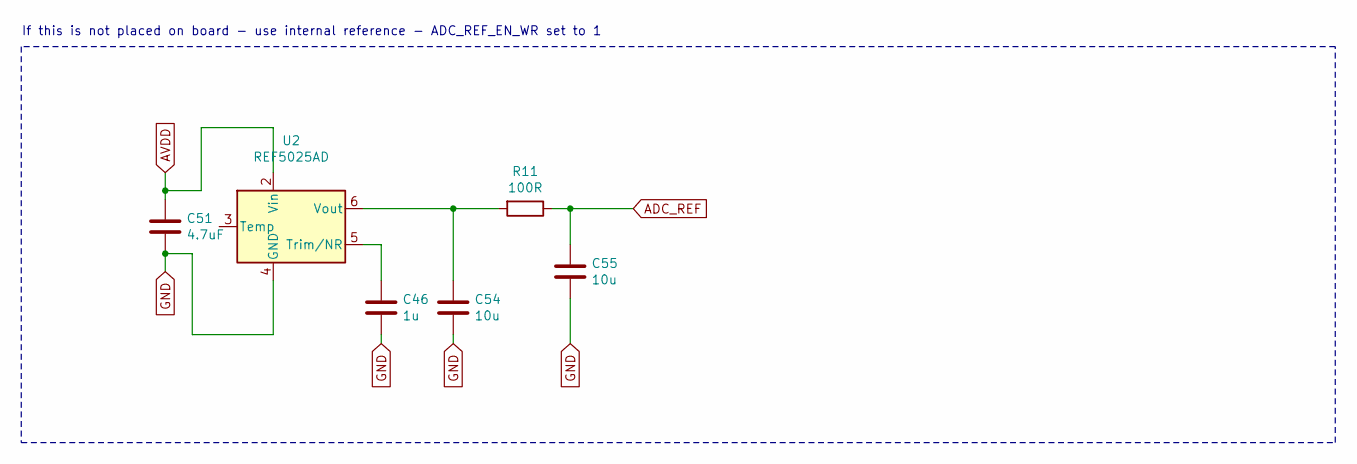
[picture p27: schematic Temperature REF.sch]

Parts:
C46: 1u; C_0603_1608Metric
C51: 4.7uF; C_0603_1608Metric
C54, C55: 10u; C_0603_1608Metric
R11: 100R; R_0805_2012Metric
U2: REF5025AD; SOIC-8_3.9x4.9mm_P1.27mm

Connections:
5V: C51.1, U2.2 (Vin); also elsewhere on the board
ADC_REF: C55.1, R11.1; also elsewhere on the board
GND: C46.2, C51.2, C54.2, C55.2, U2.4 (GND); also elsewhere on the board
unnamed: C46.1, U2.5 (Trim/NR)
unnamed: C54.1, R11.2, U2.6 (Vout)

Notes on the sheet:
If this is not placed on board - use internal reference - ADC_REF_EN_WR set to 1

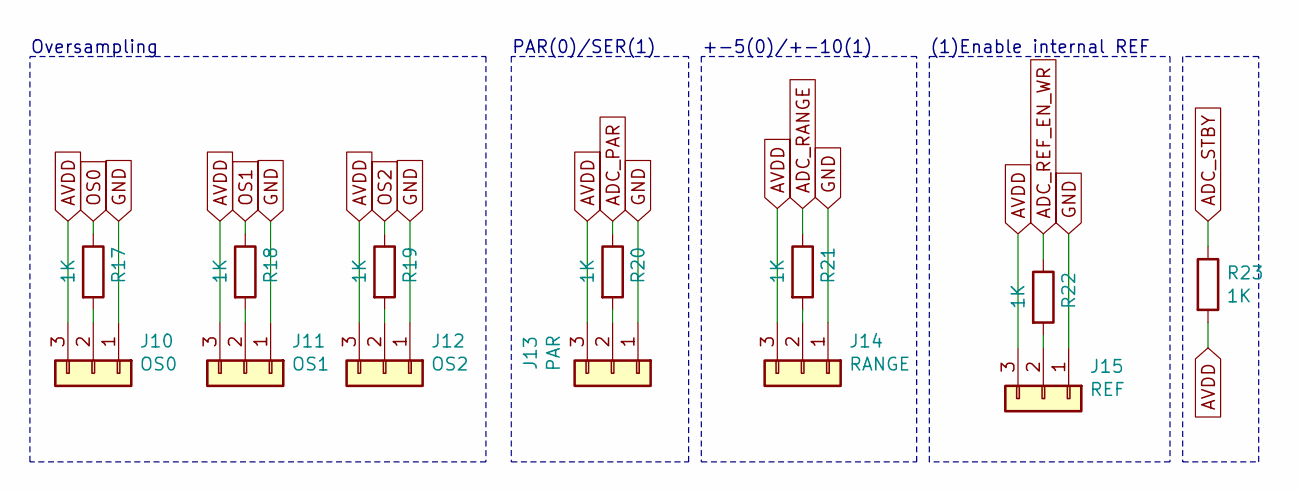
[picture p28: schematic ADC_settings.sch]

Parts:
J10: OS0; PinHeader_1x03_P2.00mm_Vertical
J11: OS1; PinHeader_1x03_P2.00mm_Vertical
J12: OS2; PinHeader_1x03_P2.00mm_Vertical
J13: PAR; PinHeader_1x03_P2.00mm_Vertical
J14: RANGE; PinHeader_1x03_P2.00mm_Vertical
J15: REF; PinHeader_1x03_P2.00mm_Vertical
R17, R18, R19, R20, R21, R22, R23: 1K; R_0805_2012Metric

Connections:
5V: J10.3, J11.3, J12.3, J13.3, J14.3, J15.3, R23.2; also elsewhere on the board
ADC_PAR: R20.1; also elsewhere on the board
ADC_RANGE: R21.1; also elsewhere on the board
ADC_REF_EN_WR: R22.1; also elsewhere on the board
ADC_STBY: R23.1; also elsewhere on the board
GND: J10.1, J11.1, J12.1, J13.1, J14.1, J15.1; also elsewhere on the board
unnamed: J10.2, R17.2
unnamed: J11.2, R18.2
unnamed: J12.2, R19.2
unnamed: J13.2, R20.2
unnamed: J14.2, R21.2
unnamed: J15.2, R22.2
OS0: R17.1; also elsewhere on the board
OS1: R18.1; also elsewhere on the board
OS2: R19.1; also elsewhere on the board

Notes on the sheet:
PAR(0)/SER(1)
+-5(0)/+-10(1)
(1)Enable internal REF
Oversampling
