goran-mahovlic/LVDS_RGB_experimental/hardware/LCD_PMOD.kicad_pcb

## KiCad design hardware/LCD_PMOD.kicad_pcb (continued)

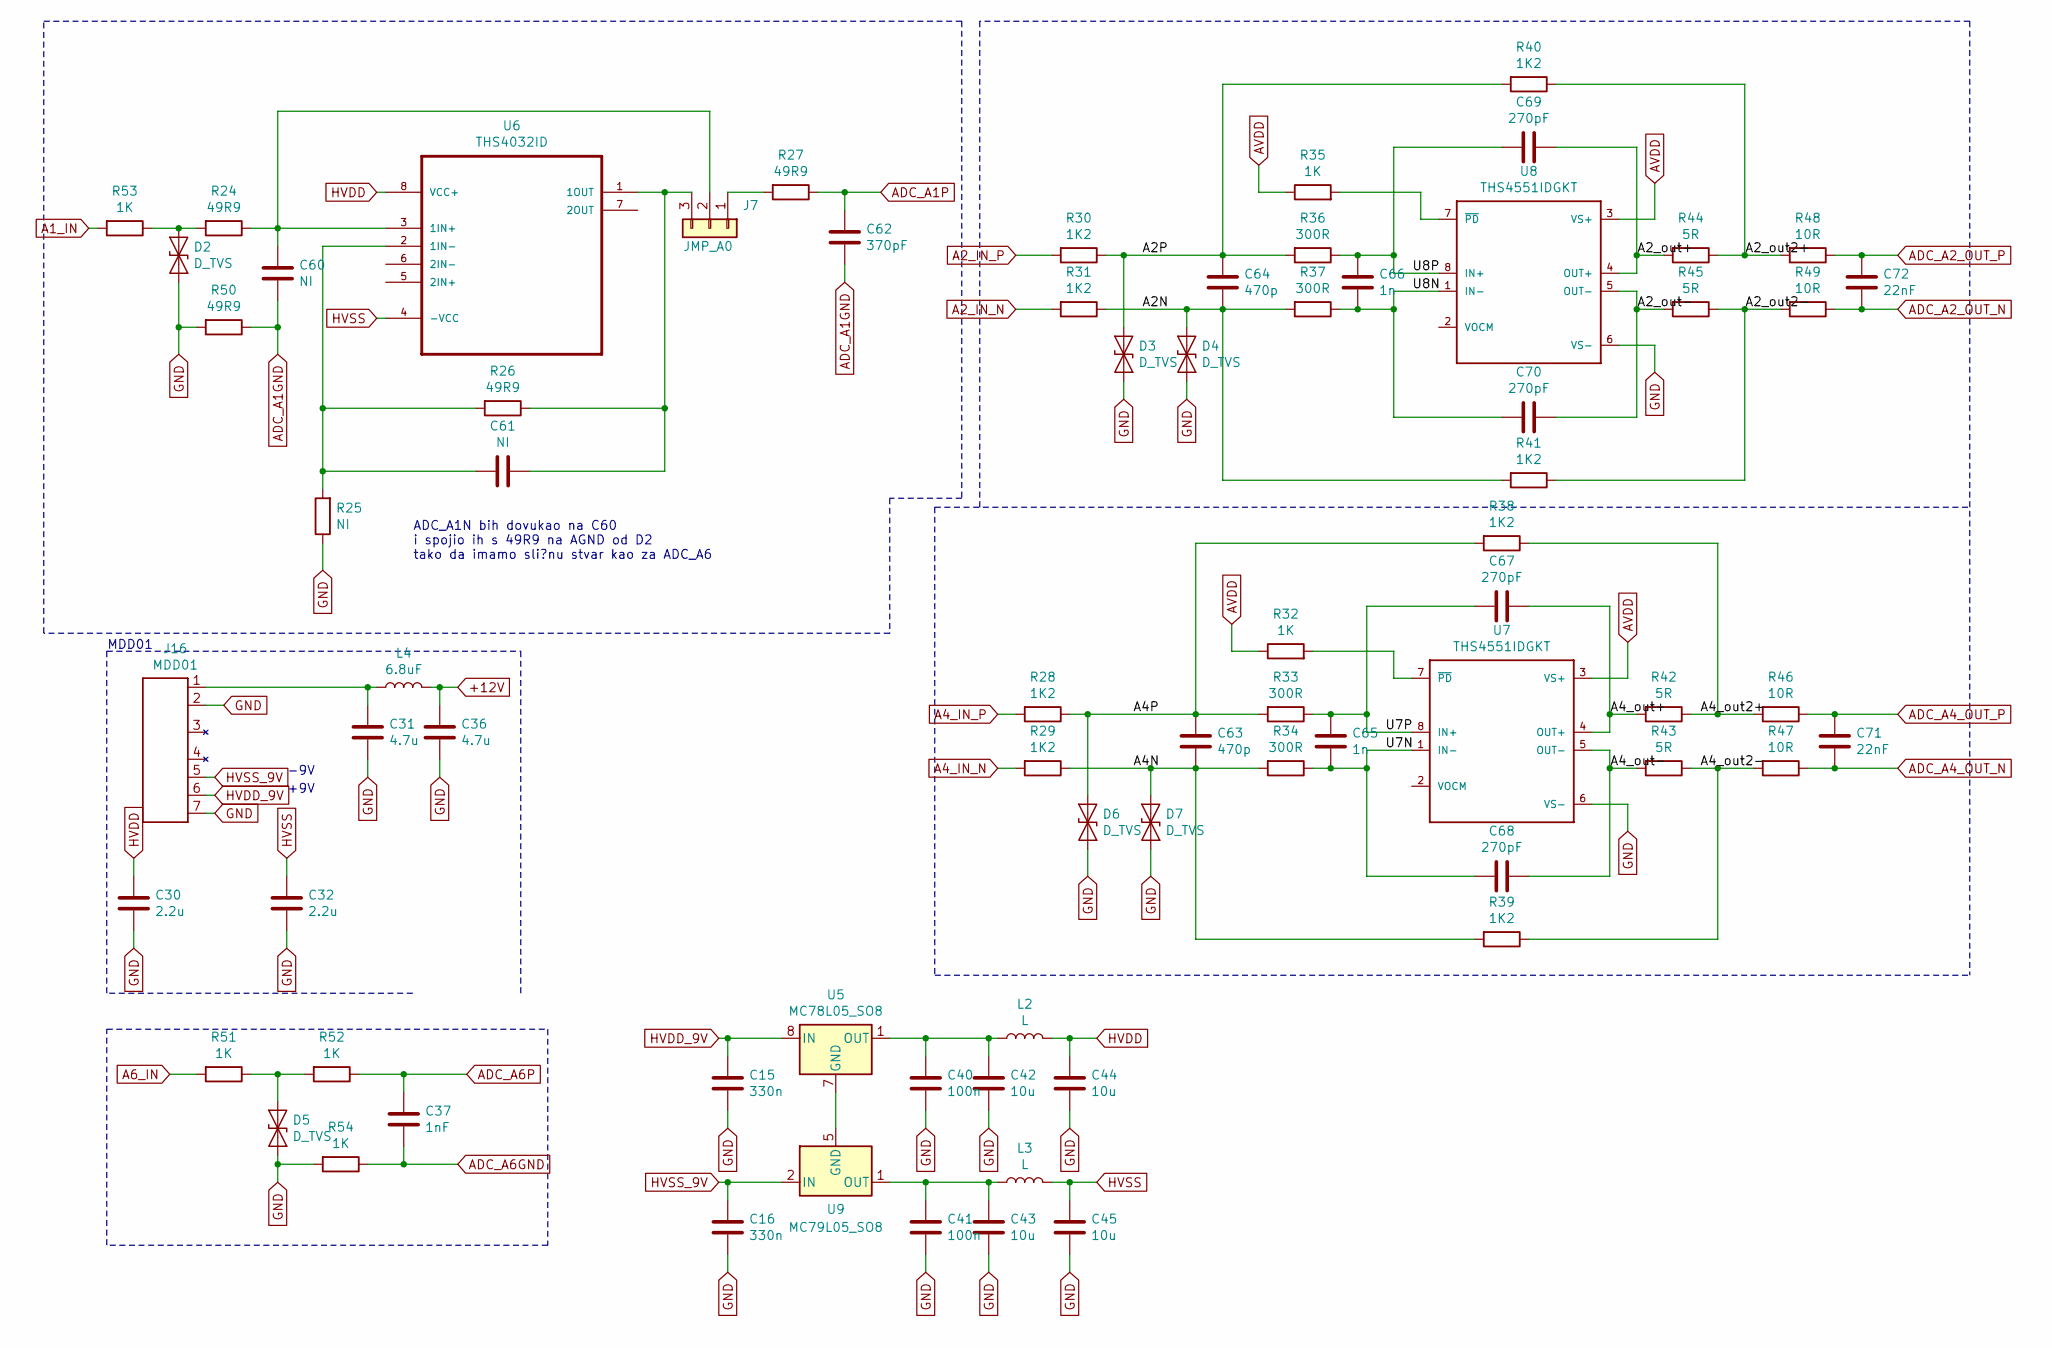
[picture p29: schematic ADC_buffer.sch]

Parts:
C15, C16: 330n; C_0603_1608Metric
C30, C32: 2.2u; C_0603_1608Metric
C31, C36: 4.7u; C_0603_1608Metric
C37: 1nF; C_0603_1608Metric
C40, C41: 100n; C_0603_1608Metric
C42, C43, C44, C45: 10u; C_0603_1608Metric
C60, C61: NI; C_0603_1608Metric
C62: 370pF; C_0603_1608Metric
C63, C64: 470p; C_0603_1608Metric
C65, C66: 1n; C_0603_1608Metric
C67, C68, C69, C70: 270pF; C_0603_1608Metric
C71, C72: 22nF; C_0603_1608Metric
D2, D3, D4, D5, D6, D7: D_TVS; D_SOD-523
J7: JMP_A0; PinHeader_1x03_P2.00mm_Vertical
J16: MDD01; MDS01
L2, L3: L; C_0603_1608Metric
L4: 6.8uF; R_0603_1608Metric
R24: 49R9; R_1206_3216Metric
R25: NI; R_0805_2012Metric
R26, R27, R50: 49R9; R_0805_2012Metric
R28, R29, R30, R31: 1K2; R_1206_3216Metric
R32, R35: 1K; R_0805_2012Metric
R33, R34, R36, R37: 300R; R_1206_3216Metric
R38, R39, R40, R41: 1K2; R_0805_2012Metric
R42, R43, R44, R45: 5R; R_0805_2012Metric
R46, R47, R48, R49: 10R; R_0805_2012Metric
R51, R52, R53, R54: 1K; R_1206_3216Metric
U5: MC78L05_SO8; SOIC-8_3.9x4.9mm_P1.27mm
U6: THS4032ID; SOIC127P600X173-8N
U7, U8: THS4551IDGKT; VSSOP-8_3.0x3.0mm_P0.65mm
U9: MC79L05_SO8; SOIC-8_3.9x4.9mm_P1.27mm

Connections:
5V: R32.1, R35.1, U7.3 (VS+), U8.3 (VS+); also elsewhere on the board
+12V: C36.1, L4.2; also elsewhere on the board
/ADC/ADC_buffer/A2N: C64.1, D4.1 (A1), R31.1, R37.2, R41.2
/ADC/ADC_buffer/A2P: C64.2, D3.1 (A1), R30.1, R36.2, R40.2
/ADC/ADC_buffer/A2_out2+: R40.1, R44.1, R48.2
/ADC/ADC_buffer/A2_out2-: R41.1, R45.1, R49.2
/ADC/ADC_buffer/A2_out+: C69.2, R44.2, U8.4 (OUT+)
/ADC/ADC_buffer/A2_out-: C70.2, R45.2, U8.5 (OUT-)
/ADC/ADC_buffer/A4N: C63.1, D7.1 (A1), R29.1, R34.2, R39.2
/ADC/ADC_buffer/A4P: C63.2, D6.1 (A1), R28.1, R33.2, R38.2
/ADC/ADC_buffer/A4_out2+: R38.1, R42.1, R46.2
/ADC/ADC_buffer/A4_out2-: R39.1, R43.1, R47.2
/ADC/ADC_buffer/A4_out+: C67.2, R42.2, U7.4 (OUT+)
/ADC/ADC_buffer/A4_out-: C68.2, R43.2, U7.5 (OUT-)
/ADC/ADC_buffer/U7N: C65.1, C68.1, R34.1, U7.1 (IN-)
/ADC/ADC_buffer/U7P: C65.2, C67.1, R33.1, U7.8 (IN+)
/ADC/ADC_buffer/U8N: C66.1, C70.1, R37.1, U8.1 (IN-)
/ADC/ADC_buffer/U8P: C66.2, C69.1, R36.1, U8.8 (IN+)
A1_IN: R53.2; also elsewhere on the board
A2_IN_N: R31.2; also elsewhere on the board
A2_IN_P: R30.2; also elsewhere on the board
A4_IN_N: R29.2; also elsewhere on the board
A4_IN_P: R28.2; also elsewhere on the board
A6_IN: R51.2; also elsewhere on the board
ADC_A1GND: C60.2, C62.2, R50.1; also elsewhere on the board
ADC_A1P: C62.1, R27.1; also elsewhere on the board
ADC_A2_OUT_N: C72.1, R49.1; also elsewhere on the board
ADC_A2_OUT_P: C72.2, R48.1; also elsewhere on the board
ADC_A4_OUT_N: C71.1, R47.1; also elsewhere on the board
ADC_A4_OUT_P: C71.2, R46.1; also elsewhere on the board
ADC_A6GND: C37.2, R54.1; also elsewhere on the board
ADC_A6P: C37.1, R52.1; also elsewhere on the board
GND: C15.2, C16.2, C30.2, C31.2, C32.2, C36.2, C40.2, C41.2, C42.2, C43.2, C44.2, C45.2, D2.2 (A2), D3.2 (A2), D4.2 (A2), D5.2 (A2), D6.2 (A2), D7.2 (A2), J16.2 (–Vin_(GND)), J16.7 (Common), R25.1, R50.2, R54.2, U7.6 (VS-), U8.6 (VS-); also elsewhere on the board
HVDD: C30.1, C44.1, L2.2, U6.8 (VCC+)
HVDD_9V: C15.1, J16.6 (+Vout), U5.8 (IN)
HVSS: C32.1, C45.1, L3.2, U6.4 (-VCC)
HVSS_9V: C16.1, J16.5 (-Vout), U9.2 (IN), U9.3 (IN), U9.6 (IN), U9.7 (IN)
unnamed: C31.1, J16.1 (+Vin_(Vcc)), L4.1
unnamed: C40.1, C42.1, L2.1, U5.1 (OUT)
unnamed: C41.1, C43.1, L3.1, U9.1 (OUT)
unnamed: C60.1, J7.2, R24.1, U6.3 (1IN+)
unnamed: C61.1, J7.3, R26.1, U6.1 (1OUT)
unnamed: C61.2, R25.2, R26.2, U6.2 (1IN-)
unnamed: D2.1 (A1), R24.2, R53.1
unnamed: D5.1 (A1), R51.1, R52.2
unnamed: J7.1, R27.2
unnamed: R32.2, U7.7 (~PD~)
unnamed: R35.2, U8.7 (~PD~)
unnamed: U5.2 (GND), U5.3 (GND), U5.6 (GND), U5.7 (GND), U9.5 (GND)

Notes on the sheet:
-9V
+9V
MDD01
ADC_A1N bih dovukao na C60 i spojio ih s 49R9 na AGND od D2 tako da imamo sli?nu stvar kao za ADC_A6

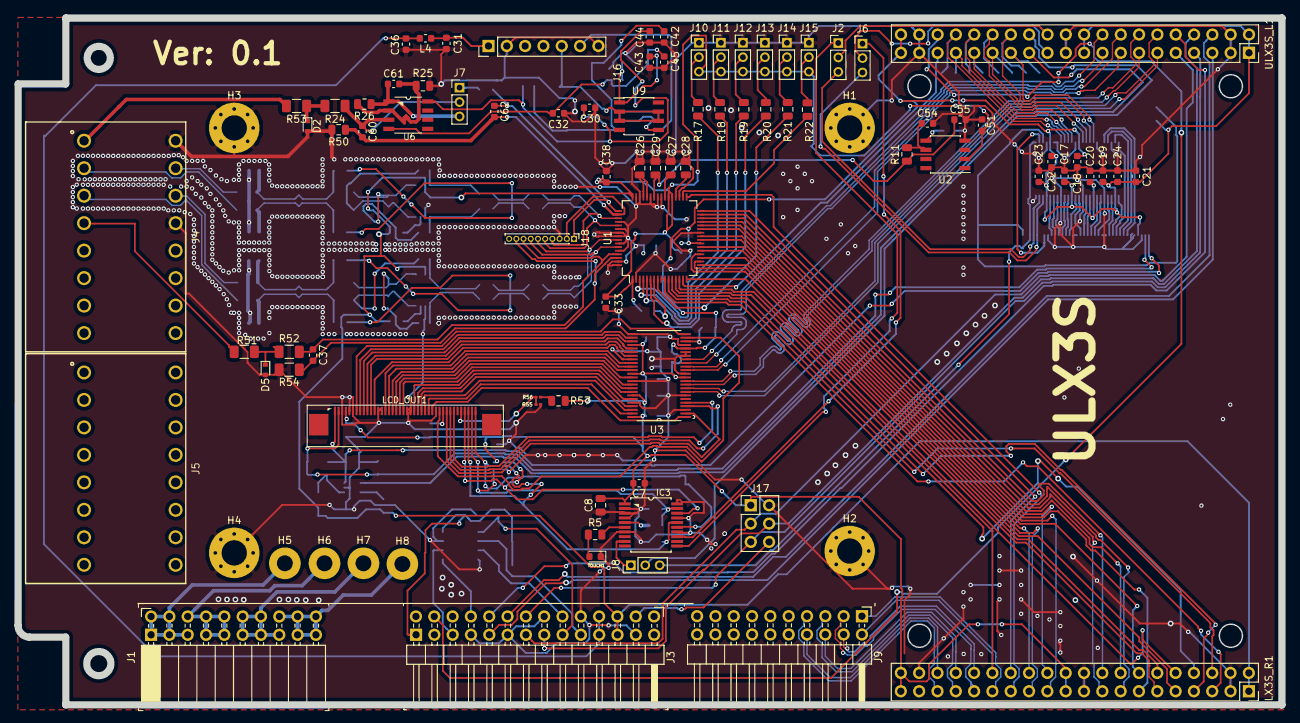
[picture p30: board LCD_PMOD.kicad_pcb from above]

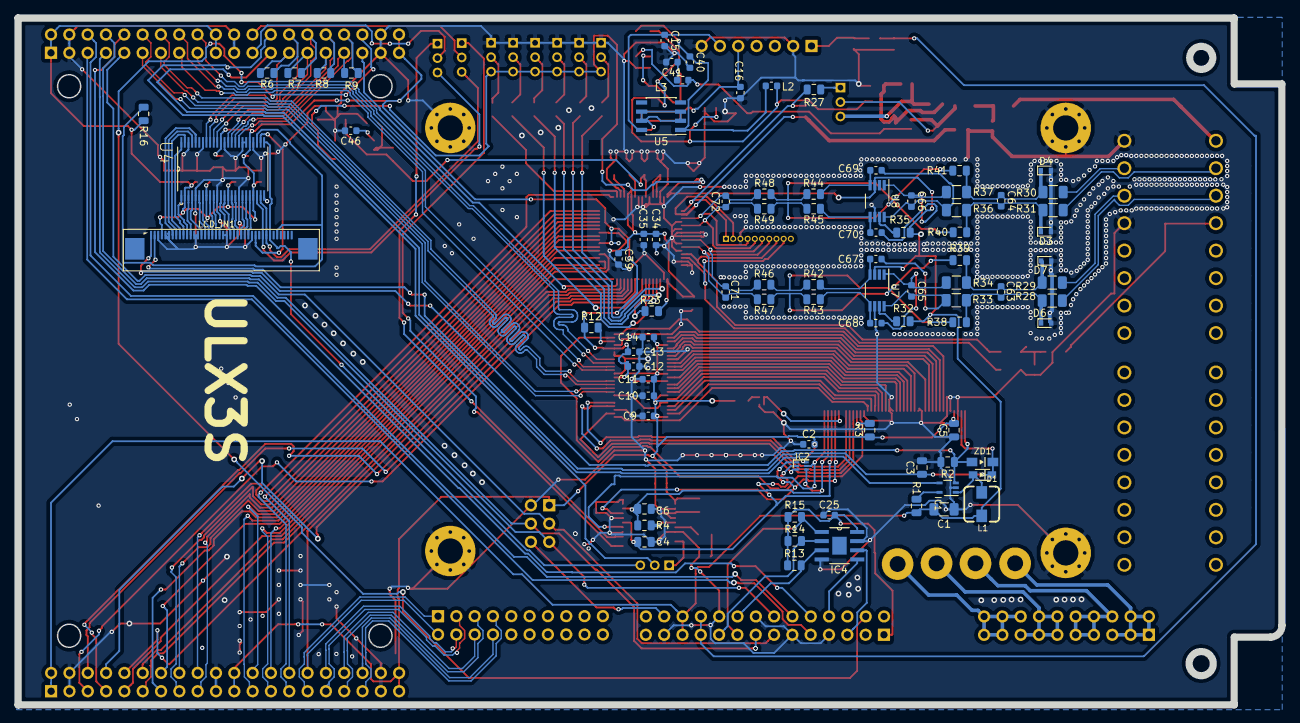
[picture p31: board LCD_PMOD.kicad_pcb from below]

Board: 2 copper layers, 175.3 x 95.2 mm, 174 parts (85 on the bottom side), 199 nets.
