goran-mahovlic/LVDS_RGB_experimental/hardware/KiCad/EEZ DIB MCU r1B2.kicad_pcb

## KiCad design hardware/KiCad/EEZ DIB MCU r1B2.kicad_pcb (2020-01-20)

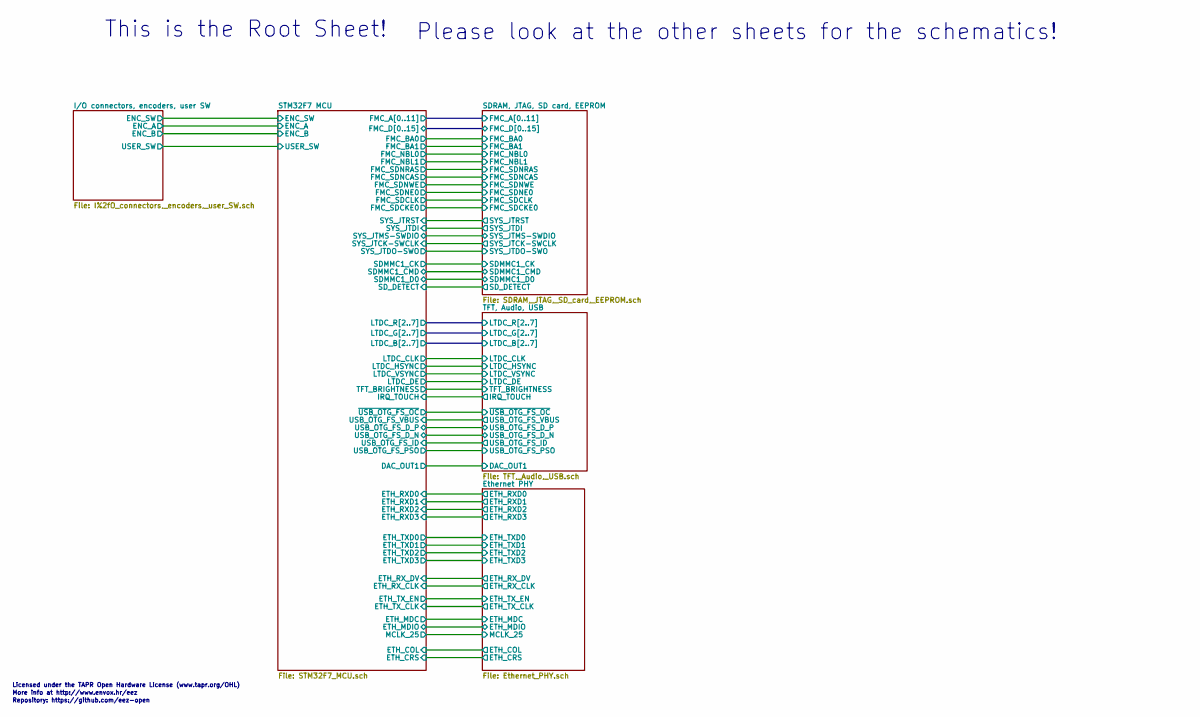
[picture p32: schematic EEZ DIB MCU r1B2.sch, EEZ DIB MUC]

Notes on the sheet:
Licensed under the TAPR Open Hardware License (www.tapr.org/OHL)
Repository: https://github.com/eez-open
More info at http://www.envox.hr/eez
This is the Root Sheet!
Please look at the other sheets for the schematics!

Schematic: I%2fO_connectors,_encoders,_user_SW.sch, EEZ DIB MUC

Parts:
C1, C4, C7: 100n; C0603
C2, C3, C5, C6: 10n; C0805
F1, F2: 50mA; F1210
IC1: TPD4E001DRLR; DRL6
IC2: SN74LVC2G34DBVR; DBV6
IC3: BTS3408G; SOIC127P600X173-8N
R1, R2, R3, R6, R7, R9: 4K7; R0805
R4, R8: 1K; R0805
R5, R10: 10K; R0805
SW1: PEC16-2215F-S0024; PEC16-2215F
SW2: TL1100CF160Q; TL1100C
X1: ZL263-40DG
X2: ZL231-16KG; ML16L
X3: 1844249; MC1,5_5-G-3,5
ZD1, ZD2: SMAJ18A; DO214AC

Connections:
+3V3: C4.1, IC2.5, R1.1, R9.1, X1.32, X2.16; also elsewhere on the board
+5V: C1.1, C7.2, IC1.6, IC3.8, X1.3, X1.4, X2.5, X2.6; also elsewhere on the board
+12V: X1.5, X1.6, X2.3, X2.4
/I/O connectors, encoders, user SW/+VAUX: X1.34, X2.10
/I/O connectors, encoders, user SW/ENC_A: C5.2, R5.1; also elsewhere on the board
/I/O connectors, encoders, user SW/ENC_B: C6.1, R10.1; also elsewhere on the board
/I/O connectors, encoders, user SW/ENC_SW: C2.2, SW1.E; also elsewhere on the board
/I/O connectors, encoders, user SW/USER_SW: C3.2, SW2.1; also elsewhere on the board
DIN1: R4.2; also elsewhere on the board
DIN2: R8.2; also elsewhere on the board
DOUT1: IC3.2; also elsewhere on the board
DOUT2: IC3.3; also elsewhere on the board
GND: C1.2, C2.1, C3.1, C4.2, C5.1, C6.2, C7.1, IC1.3, IC2.2, IC3.6, SW1.C, SW1.D, SW1.GND1, SW1.GND2, SW2.2, X1.1, X1.2, X1.7, X1.8, X1.21, X1.22, X1.35, X1.36, X1.40, X2.7, X2.8, X2.9, X3.3, ZD1.A, ZD2.A; also elsewhere on the board
I2C1_SCL: X1.28, X2.13; also elsewhere on the board
I2C1_SDA: X1.30, X2.14; also elsewhere on the board
unnamed: F1.1, X3.4
unnamed: F1.2, IC1.4, IC3.7, ZD1.C
unnamed: F2.1, X3.5
unnamed: F2.2, IC1.5, IC3.5, ZD2.C
unnamed: IC1.1, IC2.1, R3.2
unnamed: IC1.2, IC2.3, R7.2
unnamed: IC2.4, R8.1
unnamed: IC2.6, R4.1
unnamed: R1.2, R5.2, SW1.B
unnamed: R2.1, X3.1
unnamed: R2.2, R3.1
unnamed: R6.1, X3.2
unnamed: R6.2, R7.1
unnamed: R9.2, R10.2, SW1.A
OE_SYNC: X1.39; also elsewhere on the board
OUT_PAR: X1.38; also elsewhere on the board
OUT_SER: X1.37; also elsewhere on the board
PE: X2.1, X2.2; also elsewhere on the board
PWR_DIRECT: X2.12; also elsewhere on the board
PWR_SSTART: X2.11; also elsewhere on the board
SPI2_CLK: X1.9; also elsewhere on the board
SPI2_CSA: X1.15; also elsewhere on the board
SPI2_CSB: X1.17; also elsewhere on the board
SPI2_IRQ: X1.19; also elsewhere on the board
SPI2_MISO: X1.11; also elsewhere on the board
SPI2_MOSI: X1.13; also elsewhere on the board
SPI4_CLK: X1.10; also elsewhere on the board
SPI4_CSA: X1.16; also elsewhere on the board
SPI4_CSB: X1.18; also elsewhere on the board
SPI4_IRQ: X1.20; also elsewhere on the board
SPI4_MISO: X1.12; also elsewhere on the board
SPI4_MOSI: X1.14; also elsewhere on the board
SPI5_CLK: X1.23; also elsewhere on the board
SPI5_CSA: X1.29; also elsewhere on the board
SPI5_CSB: X1.31; also elsewhere on the board
SPI5_IRQ: X1.33; also elsewhere on the board
SPI5_MISO: X1.25; also elsewhere on the board
SPI5_MOSI: X1.27; also elsewhere on the board
~FAULT: IC3.1, X1.26, X2.15; also elsewhere on the board
~RESET: IC3.4, X1.24; also elsewhere on the board

Notes on the sheet:
Licensed under the TAPR Open Hardware License (www.tapr.org/OHL)
Repository: https://github.com/eez-open
More info at http://www.envox.hr/eez
Encoder shaft length: 15 mm
Knob head: A3131068 (OKW), Knob cap: A3231007 (OKW)
2 PE
Gnd 7
6 +5V
8 Gnd
10 +VAUX
4 +12V
+12V 3
PE 1
16-pin MCU socket
+5V 5
Gnd 9
SSCL 13
12 PWR_DIRECT
PWR_SSTART 11
14 SSDA
~FAULT~ 15
16 +3V3
2 Gnd
6 +12V
10 CH2_SCLK
4 +5V
+5V 3
Gnd 1
40-pin bus socket
+12V 5
CH1_SCLK 9
CH1_MOSI 13
12 CH2_MISO
CH1_MISO 11
14 CH2_MOSI
CH1_CSA 15
16 CH2_CSA
18 CH2_CSB
CH3_SCLK 23
22 Gnd
24 NRESET
26 NFAULT
20 CH2_IRQ
CH1_IRQ 19
CH1_CSB 17
Gnd 21
CH3_MISO 25
CH3_CSA 29
28 SSCL
CH3_MOSI 27
30 SSDA
CH3_CSB 31
32 +3V3
CH3_IRQ 33
OUT_SER 37
Gnd 35
OE_SYNC 39
34 +VAUX
36 Gnd
38 OUT_PAR
40 Gnd
Digital I/O with protections
Encoder with switch
User switch
Input connector (power, soft start, fan controller)
Output connector (3 x SPI modules)
Button cap: 4JRED

Schematic: TFT,_Audio,_USB.sch, EEZ DIB MUC

Parts:
C45: 4u7; C1206
C46, C50, C54: 1u; C0805
C47: 4u7; EC1206
C48: 2u2; C0805
C49, C53, C55: 100n; C0603
C51, C52, C56: 470n; C0805
C57, C58: 10n; C0805
D2: RB751V40T1G or NSR0240; SOD323-R
IC10: TPS2051BDBVR; DBV5
IC11: TPS61169DCKR; DCK5
IC12, IC14: TPD4E001DRLR; DRL6
IC13: TPA6205A1DGN; SOP65P490X110-9N
IC15: AR1021-I/SS; SOP65P780X200-20N
J2: 67803-8020; 678038020
JP4: JP3-CUT
L2: DLG-0403-4R7; DE0403
LCD1: PCA-6-LA-40-HL-3; FPC_40
Q1: MMBT5551; SOT23-BEC
R28, R30: 10R; R0805
R29, R31, R32, R40: 47K; R0805
R33, R34: 22R; R0805
R35, R37, R38: 10K; R0805
R36, R39, R41: 20K; R0805
R42: 4K7; R0805
SP1: LD-BZEL-M1313
TOUCH: HSMY-C170; LED_0805
VBUS: HSMG-C170; LED_0805
ZD3: BZX384-B30.115; SOD323-W

Connections:
+3V3: C48.1, C50.2, C53.2, C54.2, C55.2, IC13.6, IC14.6, IC15.1, LCD1.4, R31.2, R35.2, R40.2; also elsewhere on the board
+5V: C45.1, IC10.5, R28.1; also elsewhere on the board
/STM32F7 MCU/DAC_OUT1: C52.2; also elsewhere on the board
/STM32F7 MCU/IRQ_TOUCH: IC15.9; also elsewhere on the board
/STM32F7 MCU/LTDC_B2: LCD1.23; also elsewhere on the board
/STM32F7 MCU/LTDC_B3: LCD1.24; also elsewhere on the board
/STM32F7 MCU/LTDC_B4: LCD1.25; also elsewhere on the board
/STM32F7 MCU/LTDC_B5: LCD1.26; also elsewhere on the board
/STM32F7 MCU/LTDC_B6: LCD1.27; also elsewhere on the board
/STM32F7 MCU/LTDC_B7: LCD1.28; also elsewhere on the board
/STM32F7 MCU/LTDC_CLK: LCD1.30; also elsewhere on the board
/STM32F7 MCU/LTDC_DE: LCD1.34; also elsewhere on the board
/STM32F7 MCU/LTDC_G2: LCD1.15; also elsewhere on the board
/STM32F7 MCU/LTDC_G3: LCD1.16; also elsewhere on the board
/STM32F7 MCU/LTDC_G4: LCD1.17; also elsewhere on the board
/STM32F7 MCU/LTDC_G5: LCD1.18; also elsewhere on the board
/STM32F7 MCU/LTDC_G6: LCD1.19; also elsewhere on the board
/STM32F7 MCU/LTDC_G7: LCD1.20; also elsewhere on the board
/STM32F7 MCU/LTDC_HSYNC: LCD1.32; also elsewhere on the board
/STM32F7 MCU/LTDC_R2: LCD1.7; also elsewhere on the board
/STM32F7 MCU/LTDC_R3: LCD1.8; also elsewhere on the board
/STM32F7 MCU/LTDC_R4: LCD1.9; also elsewhere on the board
/STM32F7 MCU/LTDC_R5: LCD1.10; also elsewhere on the board
/STM32F7 MCU/LTDC_R6: LCD1.11; also elsewhere on the board
/STM32F7 MCU/LTDC_R7: LCD1.12; also elsewhere on the board
/STM32F7 MCU/LTDC_VSYNC: LCD1.33; also elsewhere on the board
/STM32F7 MCU/TFT_BRIGHTNESS: IC11.4 (CTRL); also elsewhere on the board
/STM32F7 MCU/USB_OTG_FS_D_N: R33.2; also elsewhere on the board
/STM32F7 MCU/USB_OTG_FS_D_P: R34.2; also elsewhere on the board
/STM32F7 MCU/USB_OTG_FS_ID: IC12.4, J2.4; also elsewhere on the board
/STM32F7 MCU/USB_OTG_FS_PSO: IC10.4; also elsewhere on the board
/STM32F7 MCU/USB_OTG_FS_VBUS: C47.+, C49.2, IC10.1, IC12.6, J2.1, R32.1; also elsewhere on the board
/STM32F7 MCU/~USB_OTG_FS_OC: IC10.3, R31.1; also elsewhere on the board
/TFT, Audio, USB/LCD_DISP: LCD1.31, R35.1
/TFT, Audio, USB/LTDC_RESET: JP4.COM, LCD1.36
/TFT, Audio, USB/SPKR+: IC13.5, R41.1, SP1.-
/TFT, Audio, USB/SPKR-: IC13.8, R36.1, SP1.+
/TFT, Audio, USB/Touch_XL: C57.1, IC14.4, IC15.19, LCD1.39, R39.2
/TFT, Audio, USB/Touch_XR: IC14.1, IC15.18, LCD1.37
/TFT, Audio, USB/Touch_YD: C58.1, IC14.2, IC15.16, LCD1.38
/TFT, Audio, USB/Touch_YU: IC14.5, IC15.15, LCD1.40
/TFT, Audio, USB/USB_D_N: IC12.1, J2.2, R33.1
/TFT, Audio, USB/USB_D_P: IC12.2, J2.3, R34.1
/TFT, Audio, USB/VLED+: C46.1, D2.C, LCD1.2, ZD3.C
/TFT, Audio, USB/VLED-: IC11.3 (FB), LCD1.1, R30.1, ZD3.A
/TFT, Audio, USB/VLED_SW: D2.A, IC11.1 (SW); also elsewhere on the board
/TFT, Audio, USB/~AUDIO_SHDN: IC13.1, R40.1
GND: C45.2, C46.2, C47.-, C48.2, C49.1, C50.1, C51.2, C53.1, C54.1, C55.1, C56.1, C57.2, C58.2, IC10.2, IC11.2 (GND), IC12.3, IC13.7, IC13.TP, IC14.3, IC15.2, IC15.3, IC15.4, IC15.7, IC15.14, IC15.17, IC15.20, J2.5, JP4.NO, LCD1.3, LCD1.5, LCD1.6, LCD1.13, LCD1.14, LCD1.21, LCD1.22, LCD1.29, Q1.E, R30.2; also elsewhere on the board
I2C1_SCL: IC15.11; also elsewhere on the board
I2C1_SDA: IC15.13; also elsewhere on the board
unnamed: C51.1, R37.2
unnamed: C52.1, R38.2
unnamed: C56.2, IC13.2
unnamed: IC11.5 (VIN), R28.2
unnamed: IC13.3, R36.2, R37.1
unnamed: IC13.4, R38.1, R41.2
unnamed: IC15.5, R39.1
unnamed: IC15.6, R42.2
unnamed: Q1.B, R32.2
unnamed: Q1.C, R29.1
unnamed 224: R29.2; also elsewhere on the board
unnamed 225: R42.1; also elsewhere on the board
PE: J2.SH1, J2.SH1.1, J2.SH2, J2.SH2.2; also elsewhere on the board
~RESET: JP4.NC; also elsewhere on the board

Notes on the sheet:
Licensed under the TAPR Open Hardware License (www.tapr.org/OHL)
Repository: https://github.com/eez-open
More info at http://www.envox.hr/eez
4.3" LCD 40-pin socket
LCD backlight DC-DC step-up converter
Consumption: +3.3 V, Typ. 17 mA
Consumption: +3.3 V, max. 33 mA; +32 V, 20 mA
Vfb = 0.204 V
LCD display: RFE43BH-AIW-DNS or RFE430Y-AIW-DNS
4.3", 480x272, resistive touch screen
USB OTG port
Resistive touchscreen controller
Audio amplifier
Consumption: +3.3 V, max. 220 mA
Tant.

Schematic: Ethernet_PHY.sch, EEZ DIB MUC

Parts:
C59, C60, C61, C62, C63, C64, C65, C67, C68, C69, C70: 100n; C0603
C66: 10u; EC1206
FB1: LCBA-600; BEAD0603
IC16: TPD4E001DRLR; DRL6
IC17: DP83848CVV_NOPB; PT48
JP5, JP6, JP7, JP8: JP2-CUT
JP9: JP2-NOCUT
R43: 1K5; R0805
R44, R45, R48, R53: 49R9; R0805
R46, R47, R49, R51, R52, R54, R57, R58, R60: 2K2; R0805
R50, R55, R56: 220R; R0805
R59: 4K87; R0603
RN1, RN2, RN3, RN4: DR1206-33R-4/8; CAY16
SPEED: LTST-C170YKT; LED_0805
X6: LMJTAB881243M-L; RJ45-TRAFO-LED

Connections:
+3V3: C59.1, C69.1, C70.1, IC16.6, IC17.32, IC17.48, R43.2, R47.1, R50.1, R51.1, R52.1, R54.1, R57.1, R58.1, R60.1; also elsewhere on the board
+3V3(A): C61.2, C63.2, C68.1, IC17.22; also elsewhere on the board
/Ethernet PHY/ETH_COL: RN2.2; also elsewhere on the board
/Ethernet PHY/ETH_CRS: JP5.1, RN1.4; also elsewhere on the board
/Ethernet PHY/ETH_MDC: IC17.31; also elsewhere on the board
/Ethernet PHY/ETH_MDIO: IC17.30, R43.1; also elsewhere on the board
/Ethernet PHY/ETH_RX+: IC16.4, IC17.14, R48.2; also elsewhere on the board
/Ethernet PHY/ETH_RX-: IC16.5, IC17.13, R53.1; also elsewhere on the board
/Ethernet PHY/ETH_RXD0: RN2.3; also elsewhere on the board
/Ethernet PHY/ETH_RXD1: RN2.4; also elsewhere on the board
/Ethernet PHY/ETH_RXD2: RN3.1; also elsewhere on the board
/Ethernet PHY/ETH_RXD3: RN3.2; also elsewhere on the board
/Ethernet PHY/ETH_RX_CLK: RN1.2; also elsewhere on the board
/Ethernet PHY/ETH_RX_DV: RN1.3; also elsewhere on the board
/Ethernet PHY/ETH_TX+: IC16.1, IC17.17, R44.2; also elsewhere on the board
/Ethernet PHY/ETH_TX-: IC16.2, IC17.16, R45.1; also elsewhere on the board
/Ethernet PHY/ETH_TXD0: RN4.1; also elsewhere on the board
/Ethernet PHY/ETH_TXD1: RN4.2; also elsewhere on the board
/Ethernet PHY/ETH_TXD2: RN4.3; also elsewhere on the board
/Ethernet PHY/ETH_TXD3: RN4.4; also elsewhere on the board
/Ethernet PHY/ETH_TX_CLK: RN3.3; also elsewhere on the board
/Ethernet PHY/ETH_TX_EN: RN3.4; also elsewhere on the board
/Ethernet PHY/LED_ACT: IC17.26, R47.2, R55.2
/Ethernet PHY/LED_LINK: IC17.28, R54.2, R56.2
/Ethernet PHY/LED_SPEED: IC17.27, R52.2; also elsewhere on the board
/Ethernet PHY/MCLK_25: RN1.1; also elsewhere on the board
/STM32F7 MCU/VDDA: FB1.P$2; also elsewhere on the board
GND: C59.2, C60.2, C61.1, C62.2, C63.1, C64.2, C65.2, C66.-, C67.2, C68.2, C69.2, C70.2, IC16.3, IC17.15, IC17.19, IC17.35, IC17.36, IC17.47, R46.1, R49.1, R59.1; also elsewhere on the board
unnamed: C60.1, R44.1, R45.2
unnamed: C62.1, R48.1, R53.2
unnamed: C64.1, C65.1, C66.+, C67.1, IC17.18, IC17.23, IC17.37
unnamed: IC17.1, RN3.6
unnamed: IC17.2, RN3.5
unnamed: IC17.3, RN4.8
unnamed: IC17.4, RN4.7
unnamed: IC17.5, RN4.6
unnamed: IC17.6, RN4.5
unnamed: IC17.7, JP9.2
unnamed: IC17.20, R58.2
unnamed: IC17.21, R57.2
unnamed: IC17.24, R59.2
unnamed: IC17.34, RN1.8
unnamed: IC17.38, RN1.7
unnamed: IC17.39, JP7.2, RN1.6
unnamed: IC17.40, RN1.5
unnamed: IC17.41, RN2.8
unnamed: IC17.42, RN2.7
unnamed: IC17.43, RN2.6
unnamed: IC17.44, RN2.5
unnamed: IC17.45, RN3.8
unnamed: IC17.46, RN3.7
unnamed: JP5.2, R49.2
unnamed: JP6.1, JP8.1, RN2.1
unnamed: JP6.2, R46.2
unnamed: JP7.1, R51.2
unnamed: JP9.1, R60.2
unnamed 226: R50.2; also elsewhere on the board
unnamed 227: R55.1; also elsewhere on the board
unnamed 228: R56.1; also elsewhere on the board
SPI5_IRQ: JP8.2; also elsewhere on the board
VDD: FB1.P$1; also elsewhere on the board
~RESET: IC17.29; also elsewhere on the board

Notes on the sheet:
Tant.
Consumption: +3.3 V, typ. 92 mA
Licensed under the TAPR Open Hardware License (www.tapr.org/OHL)
Repository: https://github.com/eez-open
More info at http://www.envox.hr/eez

Schematic: STM32F7_MCU.sch, EEZ DIB MUC

Parts:
B1: DS1092-16-B6P
C8, C9: 18p; C0603
C10: EEEFK1V470P; CAPAE660X610N
C11, C13, C14, C15, C16, C17, C18, C20, C23, C24, C25, C26, C27, C28, C29, C32: 100n; C0603
C12, C19: 4u7; EC1206
C21, C30, C31: 1u; C0805
C22: N.C.; C0603
C33, C34: 2u2; C0805
D1: SMBJ5.0A-TR; DO214AA
FM1, FM2: FIDUCIAL
IC4: STM32F769IGT6; LQFP-176_24X24MM
IC5: LD1117ADT33TR; DPACK
JP1, JP2: JP3-CUT
L1: LCBA-600; BEAD0603
R11, R12: 10K; R0805
R13, R15, R16: 4K7; R0805
R14: 1M; R0805
R17: 0R; R0805
R18: 47R; R0805
Y1: 10MHz; HC-49_4H

Connections:
+3V3: C12.+, IC5.4, R13.1, R15.1, R16.1, R17.1; also elsewhere on the board
+5V: C10.1, C11.1, D1.C, IC5.3, L1.1; also elsewhere on the board
/Ethernet PHY/ETH_COL: IC4.47; also elsewhere on the board
/Ethernet PHY/ETH_CRS: IC4.40; also elsewhere on the board
/Ethernet PHY/ETH_MDC: IC4.33; also elsewhere on the board
/Ethernet PHY/ETH_MDIO: IC4.42; also elsewhere on the board
/Ethernet PHY/ETH_RXD0: IC4.54; also elsewhere on the board
/Ethernet PHY/ETH_RXD1: IC4.55; also elsewhere on the board
/Ethernet PHY/ETH_RXD2: IC4.83; also elsewhere on the board
/Ethernet PHY/ETH_RXD3: IC4.84; also elsewhere on the board
/Ethernet PHY/ETH_RX_CLK: IC4.41; also elsewhere on the board
/Ethernet PHY/ETH_RX_DV: IC4.53; also elsewhere on the board
/Ethernet PHY/ETH_TXD0: IC4.85; also elsewhere on the board
/Ethernet PHY/ETH_TXD1: IC4.86; also elsewhere on the board
/Ethernet PHY/ETH_TXD2: IC4.34; also elsewhere on the board
/Ethernet PHY/ETH_TXD3: IC4.167; also elsewhere on the board
/Ethernet PHY/ETH_TX_CLK: IC4.35; also elsewhere on the board
/Ethernet PHY/ETH_TX_EN: IC4.80; also elsewhere on the board
/Ethernet PHY/MCLK_25: IC4.122; also elsewhere on the board
/I/O connectors, encoders, user SW/ENC_A: IC4.119; also elsewhere on the board
/I/O connectors, encoders, user SW/ENC_B: IC4.120; also elsewhere on the board
/I/O connectors, encoders, user SW/ENC_SW: IC4.173; also elsewhere on the board
/I/O connectors, encoders, user SW/USER_SW: IC4.163; also elsewhere on the board
/SDRAM, JTAG, SD card, EEPROM/FMC_A0: IC4.16; also elsewhere on the board
/SDRAM, JTAG, SD card, EEPROM/FMC_A1: IC4.17; also elsewhere on the board
/SDRAM, JTAG, SD card, EEPROM/FMC_A2: IC4.18; also elsewhere on the board
/SDRAM, JTAG, SD card, EEPROM/FMC_A3: IC4.19; also elsewhere on the board
/SDRAM, JTAG, SD card, EEPROM/FMC_A4: IC4.20; also elsewhere on the board
/SDRAM, JTAG, SD card, EEPROM/FMC_A5: IC4.21; also elsewhere on the board
/SDRAM, JTAG, SD card, EEPROM/FMC_A6: IC4.60; also elsewhere on the board
/SDRAM, JTAG, SD card, EEPROM/FMC_A7: IC4.63; also elsewhere on the board
/SDRAM, JTAG, SD card, EEPROM/FMC_A8: IC4.64; also elsewhere on the board
/SDRAM, JTAG, SD card, EEPROM/FMC_A9: IC4.65; also elsewhere on the board
/SDRAM, JTAG, SD card, EEPROM/FMC_A10: IC4.66; also elsewhere on the board
/SDRAM, JTAG, SD card, EEPROM/FMC_A11: IC4.67; also elsewhere on the board
/SDRAM, JTAG, SD card, EEPROM/FMC_BA0: IC4.112; also elsewhere on the board
/SDRAM, JTAG, SD card, EEPROM/FMC_BA1: IC4.113; also elsewhere on the board
/SDRAM, JTAG, SD card, EEPROM/FMC_D0: IC4.97; also elsewhere on the board
/SDRAM, JTAG, SD card, EEPROM/FMC_D1: IC4.98; also elsewhere on the board
/SDRAM, JTAG, SD card, EEPROM/FMC_D2: IC4.142; also elsewhere on the board
/SDRAM, JTAG, SD card, EEPROM/FMC_D3: IC4.143; also elsewhere on the board
/SDRAM, JTAG, SD card, EEPROM/FMC_D4: IC4.68; also elsewhere on the board
/SDRAM, JTAG, SD card, EEPROM/FMC_D5: IC4.69; also elsewhere on the board
/SDRAM, JTAG, SD card, EEPROM/FMC_D6: IC4.70; also elsewhere on the board
/SDRAM, JTAG, SD card, EEPROM/FMC_D7: IC4.73; also elsewhere on the board
/SDRAM, JTAG, SD card, EEPROM/FMC_D8: IC4.74; also elsewhere on the board
/SDRAM, JTAG, SD card, EEPROM/FMC_D9: IC4.75; also elsewhere on the board
/SDRAM, JTAG, SD card, EEPROM/FMC_D10: IC4.76; also elsewhere on the board
/SDRAM, JTAG, SD card, EEPROM/FMC_D11: IC4.77; also elsewhere on the board
/SDRAM, JTAG, SD card, EEPROM/FMC_D12: IC4.78; also elsewhere on the board
/SDRAM, JTAG, SD card, EEPROM/FMC_D13: IC4.89; also elsewhere on the board
/SDRAM, JTAG, SD card, EEPROM/FMC_D14: IC4.90; also elsewhere on the board
/SDRAM, JTAG, SD card, EEPROM/FMC_D15: IC4.91; also elsewhere on the board
/SDRAM, JTAG, SD card, EEPROM/FMC_NBL0: IC4.169; also elsewhere on the board
/SDRAM, JTAG, SD card, EEPROM/FMC_NBL1: IC4.170; also elsewhere on the board
/SDRAM, JTAG, SD card, EEPROM/FMC_SDCKE0: IC4.43; also elsewhere on the board
/SDRAM, JTAG, SD card, EEPROM/FMC_SDCLK: IC4.116; also elsewhere on the board
/SDRAM, JTAG, SD card, EEPROM/FMC_SDNCAS: IC4.160; also elsewhere on the board
/SDRAM, JTAG, SD card, EEPROM/FMC_SDNE0: IC4.44; also elsewhere on the board
/SDRAM, JTAG, SD card, EEPROM/FMC_SDNRAS: IC4.59; also elsewhere on the board
/SDRAM, JTAG, SD card, EEPROM/FMC_SDNWE: IC4.46; also elsewhere on the board
/SDRAM, JTAG, SD card, EEPROM/SDMMC1_CK: IC4.141; also elsewhere on the board
/SDRAM, JTAG, SD card, EEPROM/SDMMC1_CMD: IC4.144; also elsewhere on the board
/SDRAM, JTAG, SD card, EEPROM/SDMMC1_D0: IC4.121; also elsewhere on the board
/SDRAM, JTAG, SD card, EEPROM/SD_DETECT: IC4.24; also elsewhere on the board
/SDRAM, JTAG, SD card, EEPROM/SYS_JTCK-SWCLK: IC4.137; also elsewhere on the board
/SDRAM, JTAG, SD card, EEPROM/SYS_JTDI: IC4.138; also elsewhere on the board
/SDRAM, JTAG, SD card, EEPROM/SYS_JTDO-SWO: IC4.161; also elsewhere on the board
/SDRAM, JTAG, SD card, EEPROM/SYS_JTMS-SWDIO: IC4.128; also elsewhere on the board
/SDRAM, JTAG, SD card, EEPROM/SYS_JTRST: IC4.162; also elsewhere on the board
/STM32F7 MCU/BOOT0: IC4.166, JP1.COM
/STM32F7 MCU/BYPASS_REG: IC4.48, R12.2
/STM32F7 MCU/DAC_OUT1: IC4.50; also elsewhere on the board
/STM32F7 MCU/IRQ_TOUCH: IC4.151; also elsewhere on the board
/STM32F7 MCU/LTDC_B2: IC4.150; also elsewhere on the board
/STM32F7 MCU/LTDC_B3: IC4.154; also elsewhere on the board
/STM32F7 MCU/LTDC_B4: IC4.155; also elsewhere on the board
/STM32F7 MCU/LTDC_B5: IC4.174; also elsewhere on the board
/STM32F7 MCU/LTDC_B6: IC4.175; also elsewhere on the board
/STM32F7 MCU/LTDC_B7: IC4.176; also elsewhere on the board
/STM32F7 MCU/LTDC_CLK: IC4.115; also elsewhere on the board
/STM32F7 MCU/LTDC_DE: IC4.28; also elsewhere on the board
/STM32F7 MCU/LTDC_G2: IC4.52; also elsewhere on the board
/STM32F7 MCU/LTDC_G3: IC4.153; also elsewhere on the board
/STM32F7 MCU/LTDC_G4: IC4.45; also elsewhere on the board
/STM32F7 MCU/LTDC_G5: IC4.132; also elsewhere on the board
/STM32F7 MCU/LTDC_G6: IC4.13; also elsewhere on the board
/STM32F7 MCU/LTDC_G7: IC4.145; also elsewhere on the board
/STM32F7 MCU/LTDC_HSYNC: IC4.12; also elsewhere on the board
/STM32F7 MCU/LTDC_R2: IC4.139; also elsewhere on the board
/STM32F7 MCU/LTDC_R3: IC4.56; also elsewhere on the board
/STM32F7 MCU/LTDC_R4: IC4.51; also elsewhere on the board
/STM32F7 MCU/LTDC_R5: IC4.32; also elsewhere on the board
/STM32F7 MCU/LTDC_R6: IC4.57; also elsewhere on the board
/STM32F7 MCU/LTDC_R7: IC4.114; also elsewhere on the board
/STM32F7 MCU/LTDC_VSYNC: IC4.11; also elsewhere on the board
/STM32F7 MCU/RCC_OSC_IN: C8.2, IC4.29, R14.2, Y1.2
/STM32F7 MCU/RCC_OSC_OUT: C9.2, IC4.30, R14.1, Y1.1
/STM32F7 MCU/TFT_BRIGHTNESS: IC4.88; also elsewhere on the board
/STM32F7 MCU/USB_OTG_FS_D_N: IC4.126; also elsewhere on the board
/STM32F7 MCU/USB_OTG_FS_D_P: IC4.127; also elsewhere on the board
/STM32F7 MCU/USB_OTG_FS_ID: IC4.125; also elsewhere on the board
/STM32F7 MCU/USB_OTG_FS_PSO: IC4.147; also elsewhere on the board
/STM32F7 MCU/USB_OTG_FS_VBUS: IC4.124; also elsewhere on the board
/STM32F7 MCU/VBAT: IC4.6, JP2.COM
/STM32F7 MCU/VCAP1: C34.1, IC4.81
/STM32F7 MCU/VCAP2: C33.1, IC4.129
/STM32F7 MCU/VDDA: C31.1, C32.1, IC4.39, R18.2; also elsewhere on the board
/STM32F7 MCU/VREF+: IC4.38, R18.1
/STM32F7 MCU/~USB_OTG_FS_OC: IC4.146; also elsewhere on the board
/TFT, Audio, USB/VLED_SW: L1.2; also elsewhere on the board
DIN1: IC4.7; also elsewhere on the board
DIN2: IC4.8; also elsewhere on the board
DOUT1: IC4.9; also elsewhere on the board
DOUT2: IC4.10; also elsewhere on the board
GND: B1.1, B1.3, C8.1, C9.1, C10.2, C11.2, C12.-, C13.2, C14.2, C15.2, C16.2, C17.2, C18.2, C19.-, C20.2, C21.2, C22.2, C23.2, C24.2, C25.2, C26.2, C27.2, C28.2, C29.2, C30.2, C31.2, C32.2, C33.2, C34.2, D1.A, IC4.14, IC4.22, IC4.37, IC4.61, IC4.71, IC4.95, IC4.103, IC4.109, IC4.117, IC4.130, IC4.135, IC4.148, IC4.158, IC5.1, JP1.NC, R12.1; also elsewhere on the board
I2C1_SCL: IC4.164, R15.2; also elsewhere on the board
I2C1_SDA: IC4.165, R16.2; also elsewhere on the board
unnamed: B1.2, JP2.NC
unnamed: IC4.100, IC4.106
OE_SYNC: IC4.94; also elsewhere on the board
OUT_PAR: IC4.140; also elsewhere on the board
OUT_SER: IC4.152; also elsewhere on the board
PWR_DIRECT: IC4.110; also elsewhere on the board
PWR_SSTART: IC4.111; also elsewhere on the board
SPI2_CLK: IC4.133; also elsewhere on the board
SPI2_CSA: IC4.93; also elsewhere on the board
SPI2_CSB: IC4.92; also elsewhere on the board
SPI2_IRQ: IC4.123; also elsewhere on the board
SPI2_MISO: IC4.87; also elsewhere on the board
SPI2_MOSI: IC4.134; also elsewhere on the board
SPI4_CLK: IC4.1; also elsewhere on the board
SPI4_CSA: IC4.2; also elsewhere on the board
SPI4_CSB: IC4.3; also elsewhere on the board
SPI4_IRQ: IC4.168; also elsewhere on the board
SPI4_MISO: IC4.4; also elsewhere on the board
SPI4_MOSI: IC4.5; also elsewhere on the board
SPI5_CLK: IC4.25; also elsewhere on the board
SPI5_CSA: IC4.157; also elsewhere on the board
SPI5_CSB: IC4.156; also elsewhere on the board
SPI5_IRQ: IC4.79; also elsewhere on the board
SPI5_MISO: IC4.26; also elsewhere on the board
SPI5_MOSI: IC4.27; also elsewhere on the board
VDD: C13.1, C14.1, C15.1, C16.1, C17.1, C18.1, C19.+, C20.1, C21.1, C22.1, C23.1, C24.1, C25.1, C26.1, C27.1, C28.1, C29.1, C30.1, IC4.15, IC4.23, IC4.36, IC4.49, IC4.62, IC4.72, IC4.82, IC4.96, IC4.99, IC4.118, IC4.131, IC4.136, IC4.149, IC4.159, IC4.171, IC4.172, JP1.NO, JP2.NO, R11.1, R17.2; also elsewhere on the board
~FAULT: IC4.58, R13.2; also elsewhere on the board
~RESET: IC4.31, R11.2; also elsewhere on the board

Notes on the sheet:
Licensed under the TAPR Open Hardware License (www.tapr.org/OHL)
Repository: https://github.com/eez-open
More info at http://www.envox.hr/eez
Tant.
See ST AN4661 section 1.1.4
