goran-mahovlic/LVDS_RGB_experimental/hardware/KiCad/EEZ DIB MCU r1B2.kicad_pcb

## KiCad design hardware/KiCad/EEZ DIB MCU r1B2.kicad_pcb (continued)

Schematic: SDRAM,_JTAG,_SD_card,_EEPROM.sch, EEZ DIB MUC

Parts:
C35, C36, C38, C39, C40, C41, C42, C43, C44: 100n; C0603
C37: 4u7; C1206
IC6, IC7: TPD4E001DRLR; DRL6
IC8: IS42S16400J; TSOPII-54
IC9: BR24G64FVT-3AGE2; PW8_TSSOP8
J1: 503398-1892; 5033981892
JP3: JP2-NOCUT
R19, R26, R27: 47K; R0805
R20, R21: 22R; R0805
R22, R23, R24, R25: 10K; R0805
X4: ZL231-20KG; ML20L

Connections:
+3V3: C35.1, C36.1, C37.1, C38.2, C39.1, C40.1, C41.1, C42.1, C43.1, C44.1, IC6.6, IC7.6, IC8.1, IC8.3, IC8.9, IC8.14, IC8.27, IC8.43, IC8.49, IC9.1, IC9.2, IC9.3, IC9.7, IC9.8, J1.4, R19.1, R25.1, R26.1, R27.1, X4.1, X4.2; also elsewhere on the board
/SDRAM, JTAG, SD card, EEPROM/DBGACK: R24.1, X4.19
/SDRAM, JTAG, SD card, EEPROM/DBGRQ: R23.1, X4.17
/SDRAM, JTAG, SD card, EEPROM/FMC_A0: IC8.23; also elsewhere on the board
/SDRAM, JTAG, SD card, EEPROM/FMC_A1: IC8.24; also elsewhere on the board
/SDRAM, JTAG, SD card, EEPROM/FMC_A2: IC8.25; also elsewhere on the board
/SDRAM, JTAG, SD card, EEPROM/FMC_A3: IC8.26; also elsewhere on the board
/SDRAM, JTAG, SD card, EEPROM/FMC_A4: IC8.29; also elsewhere on the board
/SDRAM, JTAG, SD card, EEPROM/FMC_A5: IC8.30; also elsewhere on the board
/SDRAM, JTAG, SD card, EEPROM/FMC_A6: IC8.31; also elsewhere on the board
/SDRAM, JTAG, SD card, EEPROM/FMC_A7: IC8.32; also elsewhere on the board
/SDRAM, JTAG, SD card, EEPROM/FMC_A8: IC8.33; also elsewhere on the board
/SDRAM, JTAG, SD card, EEPROM/FMC_A9: IC8.34; also elsewhere on the board
/SDRAM, JTAG, SD card, EEPROM/FMC_A10: IC8.22; also elsewhere on the board
/SDRAM, JTAG, SD card, EEPROM/FMC_A11: IC8.35; also elsewhere on the board
/SDRAM, JTAG, SD card, EEPROM/FMC_BA0: IC8.20; also elsewhere on the board
/SDRAM, JTAG, SD card, EEPROM/FMC_BA1: IC8.21; also elsewhere on the board
/SDRAM, JTAG, SD card, EEPROM/FMC_D0: IC8.2; also elsewhere on the board
/SDRAM, JTAG, SD card, EEPROM/FMC_D1: IC8.4; also elsewhere on the board
/SDRAM, JTAG, SD card, EEPROM/FMC_D2: IC8.5; also elsewhere on the board
/SDRAM, JTAG, SD card, EEPROM/FMC_D3: IC8.7; also elsewhere on the board
/SDRAM, JTAG, SD card, EEPROM/FMC_D4: IC8.8; also elsewhere on the board
/SDRAM, JTAG, SD card, EEPROM/FMC_D5: IC8.10; also elsewhere on the board
/SDRAM, JTAG, SD card, EEPROM/FMC_D6: IC8.11; also elsewhere on the board
/SDRAM, JTAG, SD card, EEPROM/FMC_D7: IC8.13; also elsewhere on the board
/SDRAM, JTAG, SD card, EEPROM/FMC_D8: IC8.42; also elsewhere on the board
/SDRAM, JTAG, SD card, EEPROM/FMC_D9: IC8.44; also elsewhere on the board
/SDRAM, JTAG, SD card, EEPROM/FMC_D10: IC8.45; also elsewhere on the board
/SDRAM, JTAG, SD card, EEPROM/FMC_D11: IC8.47; also elsewhere on the board
/SDRAM, JTAG, SD card, EEPROM/FMC_D12: IC8.48; also elsewhere on the board
/SDRAM, JTAG, SD card, EEPROM/FMC_D13: IC8.50; also elsewhere on the board
/SDRAM, JTAG, SD card, EEPROM/FMC_D14: IC8.51; also elsewhere on the board
/SDRAM, JTAG, SD card, EEPROM/FMC_D15: IC8.53; also elsewhere on the board
/SDRAM, JTAG, SD card, EEPROM/FMC_NBL0: IC8.15; also elsewhere on the board
/SDRAM, JTAG, SD card, EEPROM/FMC_NBL1: IC8.39; also elsewhere on the board
/SDRAM, JTAG, SD card, EEPROM/FMC_SDCKE0: IC8.37; also elsewhere on the board
/SDRAM, JTAG, SD card, EEPROM/FMC_SDCLK: IC8.38; also elsewhere on the board
/SDRAM, JTAG, SD card, EEPROM/FMC_SDNCAS: IC8.17; also elsewhere on the board
/SDRAM, JTAG, SD card, EEPROM/FMC_SDNE0: IC8.19, R25.2; also elsewhere on the board
/SDRAM, JTAG, SD card, EEPROM/FMC_SDNRAS: IC8.18; also elsewhere on the board
/SDRAM, JTAG, SD card, EEPROM/FMC_SDNWE: IC8.16; also elsewhere on the board
/SDRAM, JTAG, SD card, EEPROM/RTCK: R22.1, X4.11
/SDRAM, JTAG, SD card, EEPROM/SDMMC1_CK: J1.5; also elsewhere on the board
/SDRAM, JTAG, SD card, EEPROM/SDMMC1_CMD: J1.3, R27.2; also elsewhere on the board
/SDRAM, JTAG, SD card, EEPROM/SDMMC1_D0: J1.7, R26.2; also elsewhere on the board
/SDRAM, JTAG, SD card, EEPROM/SD_DETECT: J1.SW1; also elsewhere on the board
/SDRAM, JTAG, SD card, EEPROM/SYS_JTCK-SWCLK: R21.1; also elsewhere on the board
/SDRAM, JTAG, SD card, EEPROM/SYS_JTDI: IC6.5, X4.5; also elsewhere on the board
/SDRAM, JTAG, SD card, EEPROM/SYS_JTDO-SWO: IC7.5, X4.13; also elsewhere on the board
/SDRAM, JTAG, SD card, EEPROM/SYS_JTMS-SWDIO: R20.1; also elsewhere on the board
/SDRAM, JTAG, SD card, EEPROM/SYS_JTRST: JP3.1, R19.2; also elsewhere on the board
/SDRAM, JTAG, SD card, EEPROM/TCK: IC7.1, R21.2, X4.9
/SDRAM, JTAG, SD card, EEPROM/TMS: IC6.4, R20.2, X4.7
GND: C35.2, C36.2, C37.2, C38.1, C39.2, C40.2, C41.2, C42.2, C43.2, C44.2, IC6.3, IC7.3, IC8.6, IC8.12, IC8.28, IC8.41, IC8.46, IC8.52, IC8.54, IC9.4, J1.6, J1.S, J1.SW2, R22.2, R23.2, R24.2, X4.4, X4.6, X4.8, X4.10, X4.12, X4.14, X4.16, X4.18, X4.20; also elsewhere on the board
I2C1_SCL: IC9.5; also elsewhere on the board
I2C1_SDA: IC9.6; also elsewhere on the board
unnamed: IC6.1, JP3.2, X4.3
~RESET: IC7.4, X4.15; also elsewhere on the board

Notes on the sheet:
Consumption: +3.3 V, up tp 30 mA
Licensed under the TAPR Open Hardware License (www.tapr.org/OHL)
Repository: https://github.com/eez-open
More info at http://www.envox.hr/eez
Consumption: +3.3 V, up tp 110 mA
I2C address read: 0xA1
I2C address write: 0xA0
I2C EEPROM
Skratiti za BR24G08FVJ-3AGTE2 ~~~
IMPORTANT: For PCB layout consult ST AN4661 section 8.4.2
See AN4661 section 8.4.1
Micro SD card socket

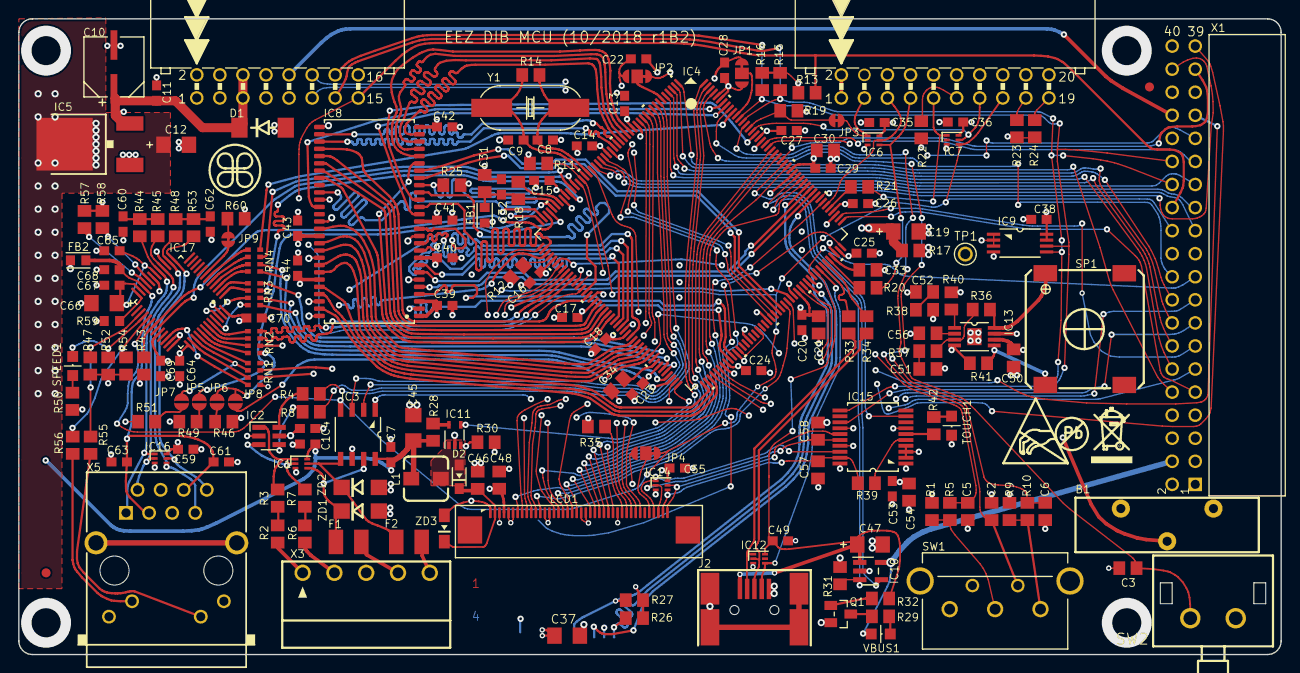
[picture p33: board EEZ DIB MCU r1B2.kicad_pcb from above]

Board: 4 copper layers, 139.0 x 70.0 mm, 194 parts (0 on the bottom side), 233 nets.

Other parts of the board:
EEZ_SIGNATURE: SIGNATURESMALL; SIGNATURE_5MM
FB2: LCBA-600; BEAD0603
SPEED1: LTST-C170YKT; LED_0805
TOUCH1: HSMY-C170; LED_0805
TP1: PCB_TEST_TABSHIELD; PCB_SHIELD_TAB
U$1: RECYCLE_BIN1_8
U$5: PB_SMALL
U$6: ESD_SYMBOL
VBUS1: HSMG-C170; LED_0805
X5: LMJTAB881243M-L; RJ45-TRAFO-LED

Their connections:
+3V3: FB2.P$1, X5.9, X5.12; also elsewhere on the board
+3V3(A): FB2.P$2, X5.3, X5.6; also elsewhere on the board
+5V: VBUS1.A; also elsewhere on the board
/Ethernet PHY/ETH_RX+: X5.7; also elsewhere on the board
/Ethernet PHY/ETH_RX-: X5.8; also elsewhere on the board
/Ethernet PHY/ETH_TX+: X5.1; also elsewhere on the board
/Ethernet PHY/ETH_TX-: X5.2; also elsewhere on the board
/Ethernet PHY/LED_SPEED: SPEED1.C; also elsewhere on the board
GND: TOUCH1.C, TP1.1, X5.4, X5.5; also elsewhere on the board
unnamed 224: VBUS1.C; also elsewhere on the board
unnamed 225: TOUCH1.A; also elsewhere on the board
unnamed 226: SPEED1.A; also elsewhere on the board
unnamed 227: X5.11; also elsewhere on the board
unnamed 228: X5.10; also elsewhere on the board
PE: X5.SH, X5.SH2; also elsewhere on the board
