goran-mahovlic/LVDS_RGB_experimental/(commit log)

2020-01-20 adding initial work in progress schematics/PCB/3D
    [691327310012_Download_STP_691327310012_rev1.stp, 691327310016_Download_STP_691327310016_rev1.stp, ADC.sch, DIB_v1.sch, DIB_v2.sch, EEZ DIB MCU r1B1.kicad_pcb, EEZ DIB MCU r1B1.sch, EEZ DIB MCU r1B2.kicad_pcb]
2020-01-22 Adding decoupling capacitors, termination resoistors for LVDS IN
    [ADC.sch, LCD.sch, Video_IN.sch]
2020-01-22 Adding pin enable to ADS8556IPM
2020-01-22 Adding selection resistors
    [ADC.sch, LCD.sch, Video_IN.sch]
2020-01-23 Adding buffe ramp , REF amp, DIFF amp
    [ADC.sch, ADC_buffer.sch, ADC_settings.sch, DIB_v1.sch, DIB_v2.sch, LCD.sch, LCD_PMOD.sch, Temperature REF.sch]
2020-01-23 Adding AMC1304 to the board
    [ADC_buffer.sch]
2020-01-25 Adding Bias_PS from dcm220
    [ADC.sch, ADC_buffer.sch, ADC_settings.sch, Bias_PS.sch, DIB_v1.sch, DIB_v2.sch, LCD.sch, LCD_PMOD.sch]
2020-01-27 Adding ULX3S connections
    [ADC.sch, ADC_buffer.sch, Bias_PS.sch, DIB_v1.sch, DIB_v2.sch, LCD.sch, ULX3S.sch, Video_IN.sch]
2020-01-27 Assigning footprints
    [ADC.sch, ADC_buffer.sch, ADC_settings.sch, Bias_PS.sch, DIB_v1.sch, DIB_v2.sch, LCD.sch, LCD_PMOD.kicad_pcb]
2020-01-28 Adding chip power down fix - removing ADS8556 chip
    [ADC.sch, ADC_buffer.sch, LCD.sch, LCD_PMOD.kicad_pcb]
2020-01-28 Adding ads8586s to shematics
    [ADC.sch]
2020-01-29 Partially connecting ads8586s
    [ADC.sch, ULX3S.sch, Video_IN.sch]
2020-01-29 Adding last known changes to shematics
    [ADC.sch, ADC_buffer.sch, ADC_settings.sch, Bias_PS.sch, DIB_v1.sch, DIB_v2.sch, LCD.sch, LCD_PMOD.kicad_pcb]
2020-01-29 Renaming wires
    [ADC_buffer.sch, DIB_v1.sch, DIB_v2.sch, Temperature REF.sch, ULX3S.sch, Video_IN.sch]
2020-02-07 Routing board
    [ADC.sch, ADC_buffer.sch, ADC_settings.sch, DIB_v1.sch, DIB_v2.sch, LCD.sch, LCD_PMOD.kicad_pcb, ULX3S.sch]
2020-02-08 Before AGND - GND
    [ADC.sch, DIB_v1.sch, DIB_v2.sch, LCD.sch, LCD_PMOD.kicad_pcb, ULX3S.sch, Video_IN.sch]
2020-02-12 Finishing routing
    [ADC.sch, ADC_buffer.sch, ADC_settings.sch, LCD.sch, LCD_PMOD.kicad_pcb, Temperature REF.sch, ULX3S.sch]
2020-02-12 Adding pcb changes to PBC
    [ADC.sch, ADC_buffer.sch, LCD_PMOD.kicad_pcb, Temperature REF.sch]
2020-02-12 Adding DIB_V1 connectors
2020-02-13 Moving ULX3S connector lower
    [LCD_PMOD.kicad_pcb]
2020-02-15 Adding Gerbers
    [LCD_PMOD-B.Cu.gbr, LCD_PMOD-B.Mask.gbr, LCD_PMOD-B.Paste.gbr, LCD_PMOD-B.SilkS.gbr, LCD_PMOD-Edge.Cuts.gbr, LCD_PMOD-F.Cu.gbr, LCD_PMOD-F.Mask.gbr, LCD_PMOD-F.Paste.gbr]
2020-02-15 Board V0.1
    [LCD_PMOD.kicad_pcb]
2020-02-15 Adding version number
    [LCD_PMOD.kicad_pcb]
2020-02-17 Adding initial BOM list
    [1-click-bom.csv, LCD_PMOD.ods]
